RabbitTigers/CN0566Allegro2KiCAD/PABA-DP.kicad_pcb

## KiCad design PABA-DP.kicad_pcb (2025-05-30)

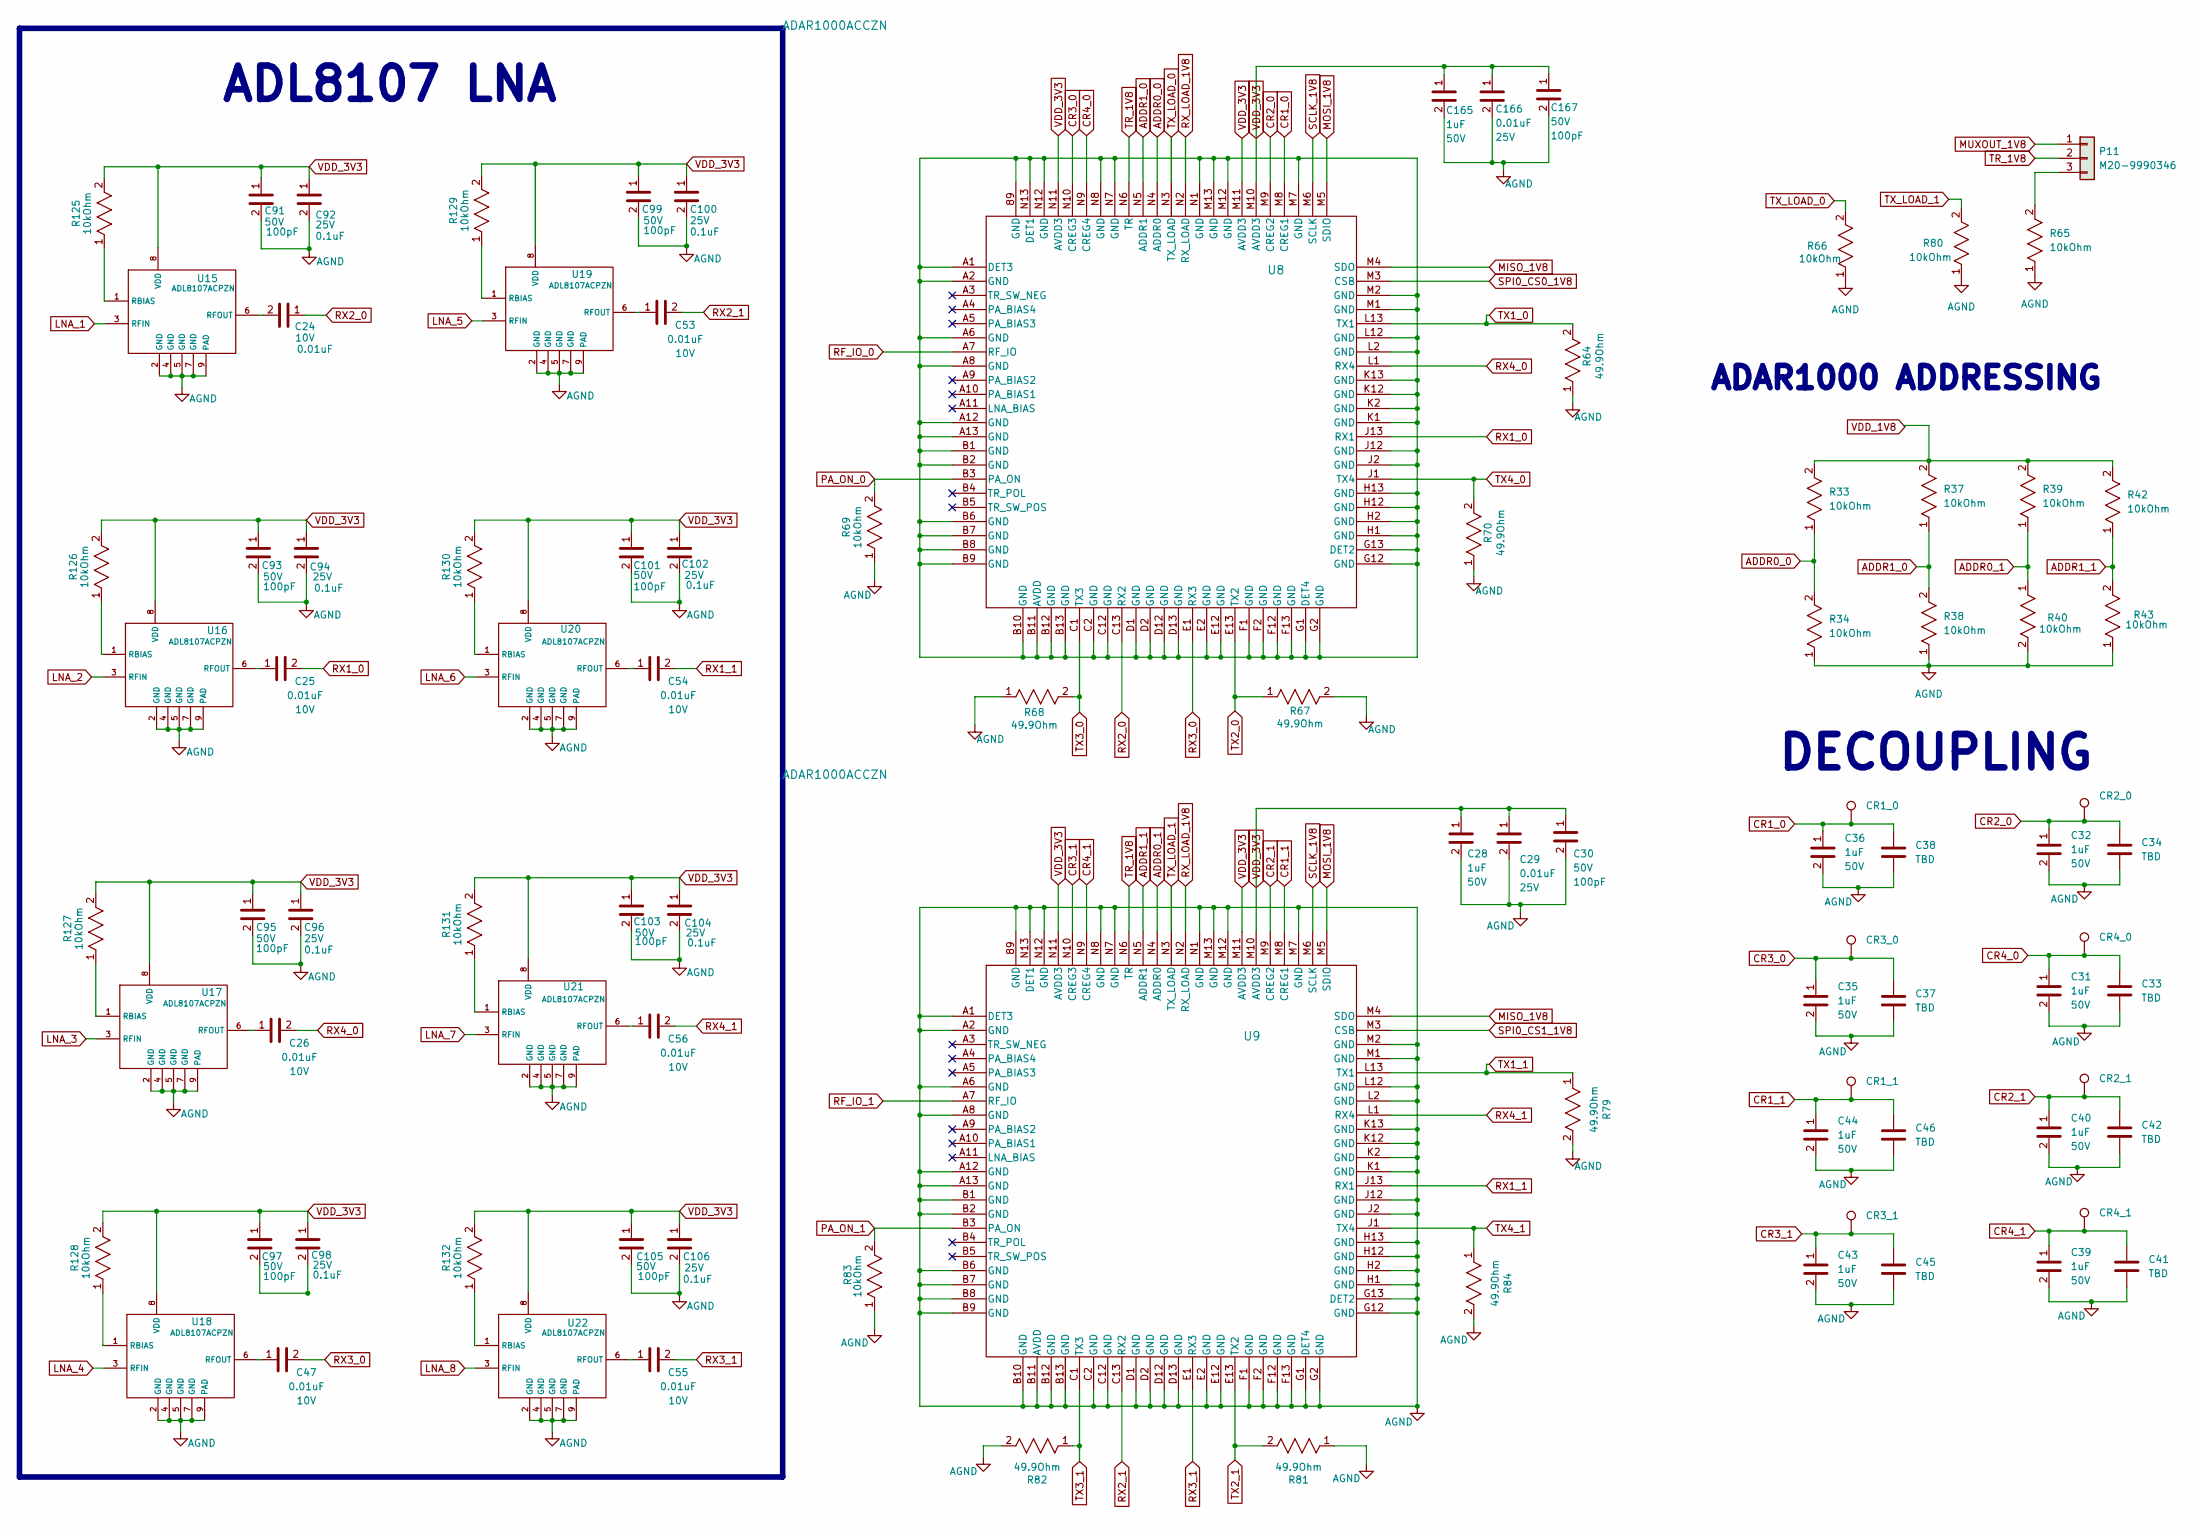
[picture p1: schematic 5.kicad_sch]

Parts:
C24, C25, C26, C47, C53, C54, C55, C56: GRM033R71A103KA01D; C_0201_0603Metric
C28, C31, C32, C35, C36, C39, C40, C43, C44, C165: CL10A105KB8NNNC; C_0603_1608Metric
C29, C166: CL10B103KA8NNNC; C_0603_1608Metric
C30, C91, C93, C95, C97, C99, C101, C103, C105, C167: CC0603KRX7R9BB101; C_0603_1608Metric
C33, C34, C37, C38, C41, C42, C45, C46: TBD; C_0402_1005Metric
C92, C94, C96, C98, C100, C102, C104, C106: CL10B104KA8NNNC; C_0603_1608Metric
CR1_0, CR1_1, CR2_0, CR2_1, CR3_0, CR3_1, CR4_0, CR4_1: TestPoint; Testpoint
P11: M20-9990346; PinHeader_1x03_P2.54mm_Vertical
R33, R34, R37, R38, R39, R40, R42, R43, R65, R66, R69, R80, R83, R125, R126, R127, R128, R129, R130, R131, R132: ERJ-3EKF1002V; R_0603_1608Metric
R64, R67, R68, R70, R79, R81, R82, R84: ERJ-1GNF49R9C; R_0201_0603Metric
U8, U9: ADAR1000ACCZN
U15, U16, U17, U18, U19, U20, U21, U22: ADL8107ACPZN; ADL8107ACPZN-R7

Connections:
ADDR0_0: U8.N4 (ADDR0)
ADDR0_1: R39.1, R40.1, U9.N4 (ADDR0)
ADDR1_0: R37.1, R38.2, U8.N5 (ADDR1)
ADDR1_1: R42.1, R43.2, U9.N5 (ADDR1)
AGND: C28.2, C29.2, C30.2, C31.2, C32.2, C33.2, C34.2, C35.2, C36.2, C37.2, C38.2, C39.2, C40.2, C41.2, C42.2, C43.2, C44.2, C45.2, C46.2, C91.2, C92.2, C93.2, C94.2, C95.2, C96.2, C99.2, C100.2, C101.2, C102.2, C103.2, C104.2, C105.2, C106.2, C165.2, C166.2, C167.2, R34.1, R38.1, R40.2, R43.1, R64.1, R65.1, R66.1, R67.2, R68.1, R69.1, R70.1, R79.2, R80.1, R81.1, R82.2, R83.1, R84.2, U9.89 (GND), U9.A1 (DET3), U9.A2 (GND), U9.A6 (GND), U9.A8 (GND), U9.A12 (GND), U9.A13 (GND), U9.B1 (GND), U9.B2 (GND), U9.B6 (GND), U9.B7 (GND), U9.B8 (GND), U9.B9 (GND), U9.B10 (GND), U9.B11 (AVDD), U9.B12 (GND), U9.B13 (GND), U9.C2 (GND), U9.C12 (GND), U9.D1 (GND), U9.D2 (GND), U9.D12 (GND), U9.D13 (GND), U9.E2 (GND), U9.E12 (GND), U9.F1 (GND), U9.F2 (GND), U9.F12 (GND), U9.F13 (GND), U9.G1 (DET4), U9.G2 (GND), U9.G12 (GND), U9.G13 (DET2), U9.H1 (GND), U9.H2 (GND), U9.H12 (GND), U9.H13 (GND), U9.J2 (GND), U9.J12 (GND), U9.K1 (GND), U9.K2 (GND), U9.K12 (GND), U9.K13 (GND), U9.L2 (GND), U9.L12 (GND), U9.M1 (GND), U9.M2 (GND), U9.M7 (GND), U9.M12 (GND), U9.M13 (GND), U9.N1 (GND), U9.N7 (GND), U9.N8 (GND), U9.N12 (GND), U9.N13 (DET1), U15.2 (GND), U15.4 (GND), U15.5 (GND), U15.7 (GND), U15.9 (PAD), U16.2 (GND), U16.4 (GND), U16.5 (GND), U16.7 (GND), U16.9 (PAD), U17.2 (GND), U17.4 (GND), U17.5 (GND), U17.7 (GND), U17.9 (PAD), U18.2 (GND), U18.4 (GND), U18.5 (GND), U18.7 (GND), U18.9 (PAD), U19.2 (GND), U19.4 (GND), U19.5 (GND), U19.7 (GND), U19.9 (PAD), U20.2 (GND), U20.4 (GND), U20.5 (GND), U20.7 (GND), U20.9 (PAD), U21.2 (GND), U21.4 (GND), U21.5 (GND), U21.7 (GND), U21.9 (PAD), U22.2 (GND), U22.4 (GND), U22.5 (GND), U22.7 (GND), U22.9 (PAD); also elsewhere on the board
CR1_0: C36.1, C38.1, CR1_0.1, U8.M8 (CREG1)
CR1_1: C44.1, C46.1, CR1_1.1, U9.M8 (CREG1)
CR2_0: C32.1, C34.1, CR2_0.1, U8.M9 (CREG2)
CR2_1: C40.1, C42.1, CR2_1.1, U9.M9 (CREG2)
CR3_0: C35.1, C37.1, CR3_0.1, U8.N10 (CREG3)
CR3_1: C43.1, C45.1, CR3_1.1, U9.N10 (CREG3)
CR4_0: C31.1, C33.1, CR4_0.1, U8.N9 (CREG4)
CR4_1: C39.1, C41.1, CR4_1.1, U9.N9 (CREG4)
LNA_1: U15.3 (RFIN); also elsewhere on the board
LNA_2: U16.3 (RFIN); also elsewhere on the board
LNA_3: U17.3 (RFIN); also elsewhere on the board
LNA_4: U18.3 (RFIN); also elsewhere on the board
LNA_5: U19.3 (RFIN); also elsewhere on the board
LNA_6: U20.3 (RFIN); also elsewhere on the board
LNA_7: U21.3 (RFIN); also elsewhere on the board
LNA_8: U22.3 (RFIN); also elsewhere on the board
MISO_1V8: U8.M4 (SDO), U9.M4 (SDO); also elsewhere on the board
MOSI_1V8: U8.M5 (SDIO), U9.M5 (SDIO); also elsewhere on the board
MUXOUT_1V8: P11.1; also elsewhere on the board
unnamed: C97.2, C98.2
unnamed: P11.3, R65.2
unnamed: R33.1, R34.2
unnamed: U8.89 (GND), U8.A1 (DET3), U8.A2 (GND), U8.A6 (GND), U8.A8 (GND), U8.A12 (GND), U8.A13 (GND), U8.B1 (GND), U8.B2 (GND), U8.B6 (GND), U8.B7 (GND), U8.B8 (GND), U8.B9 (GND), U8.B10 (GND), U8.B11 (AVDD), U8.B12 (GND), U8.B13 (GND), U8.C2 (GND), U8.C12 (GND), U8.D1 (GND), U8.D2 (GND), U8.D12 (GND), U8.D13 (GND), U8.E2 (GND), U8.E12 (GND), U8.F1 (GND), U8.F2 (GND), U8.F12 (GND), U8.F13 (GND), U8.G1 (DET4), U8.G2 (GND), U8.G12 (GND), U8.G13 (DET2), U8.H1 (GND), U8.H2 (GND), U8.H12 (GND), U8.H13 (GND), U8.J2 (GND), U8.J12 (GND), U8.K1 (GND), U8.K2 (GND), U8.K12 (GND), U8.K13 (GND), U8.L2 (GND), U8.L12 (GND), U8.M1 (GND), U8.M2 (GND), U8.M7 (GND), U8.M12 (GND), U8.M13 (GND), U8.N1 (GND), U8.N7 (GND), U8.N8 (GND), U8.N12 (GND), U8.N13 (DET1)
unnamed: R125.1, U15.1 (RBIAS)
unnamed: C24.2, U15.6 (RFOUT)
unnamed: R126.1, U16.1 (RBIAS)
unnamed: C25.1, U16.6 (RFOUT)
unnamed: R127.1, U17.1 (RBIAS)
unnamed: C26.1, U17.6 (RFOUT)
unnamed: R128.1, U18.1 (RBIAS)
unnamed: C47.1, U18.6 (RFOUT)
unnamed: R129.1, U19.1 (RBIAS)
unnamed: C53.1, U19.6 (RFOUT)
unnamed: R130.1, U20.1 (RBIAS)
unnamed: C54.1, U20.6 (RFOUT)
unnamed: R131.1, U21.1 (RBIAS)
unnamed: C56.1, U21.6 (RFOUT)
unnamed: R132.1, U22.1 (RBIAS)
unnamed: C55.1, U22.6 (RFOUT)
PA_ON_0: R69.2, U8.B3 (PA_ON)
PA_ON_1: R83.2, U9.B3 (PA_ON)
RF_IO_0: U8.A7 (RF_IO); also elsewhere on the board
RF_IO_1: U9.A7 (RF_IO); also elsewhere on the board
RX1_0: C25.2, U8.J13 (RX1)
RX1_1: C54.2, U9.J13 (RX1)
RX2_0: C24.1, U8.C13 (RX2)
RX2_1: C53.2, U9.C13 (RX2)
RX3_0: C47.2, U8.E1 (RX3)
RX3_1: C55.2, U9.E1 (RX3)
RX4_0: C26.2, U8.L1 (RX4)
RX4_1: C56.2, U9.L1 (RX4)
RX_LOAD_1V8: U8.N2 (RX_LOAD), U9.N2 (RX_LOAD); also elsewhere on the board
SCLK_1V8: U8.M6 (SCLK), U9.M6 (SCLK); also elsewhere on the board
SPI0_CS0_1V8: U8.M3 (CSB); also elsewhere on the board
SPI0_CS1_1V8: U9.M3 (CSB); also elsewhere on the board
TR_1V8: P11.2, U8.N6 (TR), U9.N6 (TR); also elsewhere on the board
TX1_0: R64.2, U8.L13 (TX1)
TX1_1: R79.1, U9.L13 (TX1)
TX2_0: R67.1, U8.E13 (TX2)
TX2_1: R81.2, U9.E13 (TX2)
TX3_0: R68.2, U8.C1 (TX3)
TX3_1: R82.1, U9.C1 (TX3)
TX4_0: R70.2, U8.J1 (TX4)
TX4_1: R84.1, U9.J1 (TX4)
TX_LOAD_0: R66.2, U8.N3 (TX_LOAD)
TX_LOAD_1: R80.2, U9.N3 (TX_LOAD)
VDD_1V8: R33.2, R37.2, R39.2, R42.2; also elsewhere on the board
VDD_3V3: C28.1, C29.1, C30.1, C91.1, C92.1, C93.1, C94.1, C95.1, C96.1, C97.1, C98.1, C99.1, C100.1, C101.1, C102.1, C103.1, C104.1, C105.1, C106.1, C165.1, C166.1, C167.1, R125.2, R126.2, R127.2, R128.2, R129.2, R130.2, R131.2, R132.2, U8.M10 (AVDD3), U8.M11 (AVDD3), U8.N11 (AVDD3), U9.M10 (AVDD3), U9.M11 (AVDD3), U9.N11 (AVDD3), U15.8 (VDD), U16.8 (VDD), U17.8 (VDD), U18.8 (VDD), U19.8 (VDD), U20.8 (VDD), U21.8 (VDD), U22.8 (VDD); also elsewhere on the board

Notes on the sheet:
ADL8107 LNA
ADAR1000 ADDRESSING
DECOUPLING

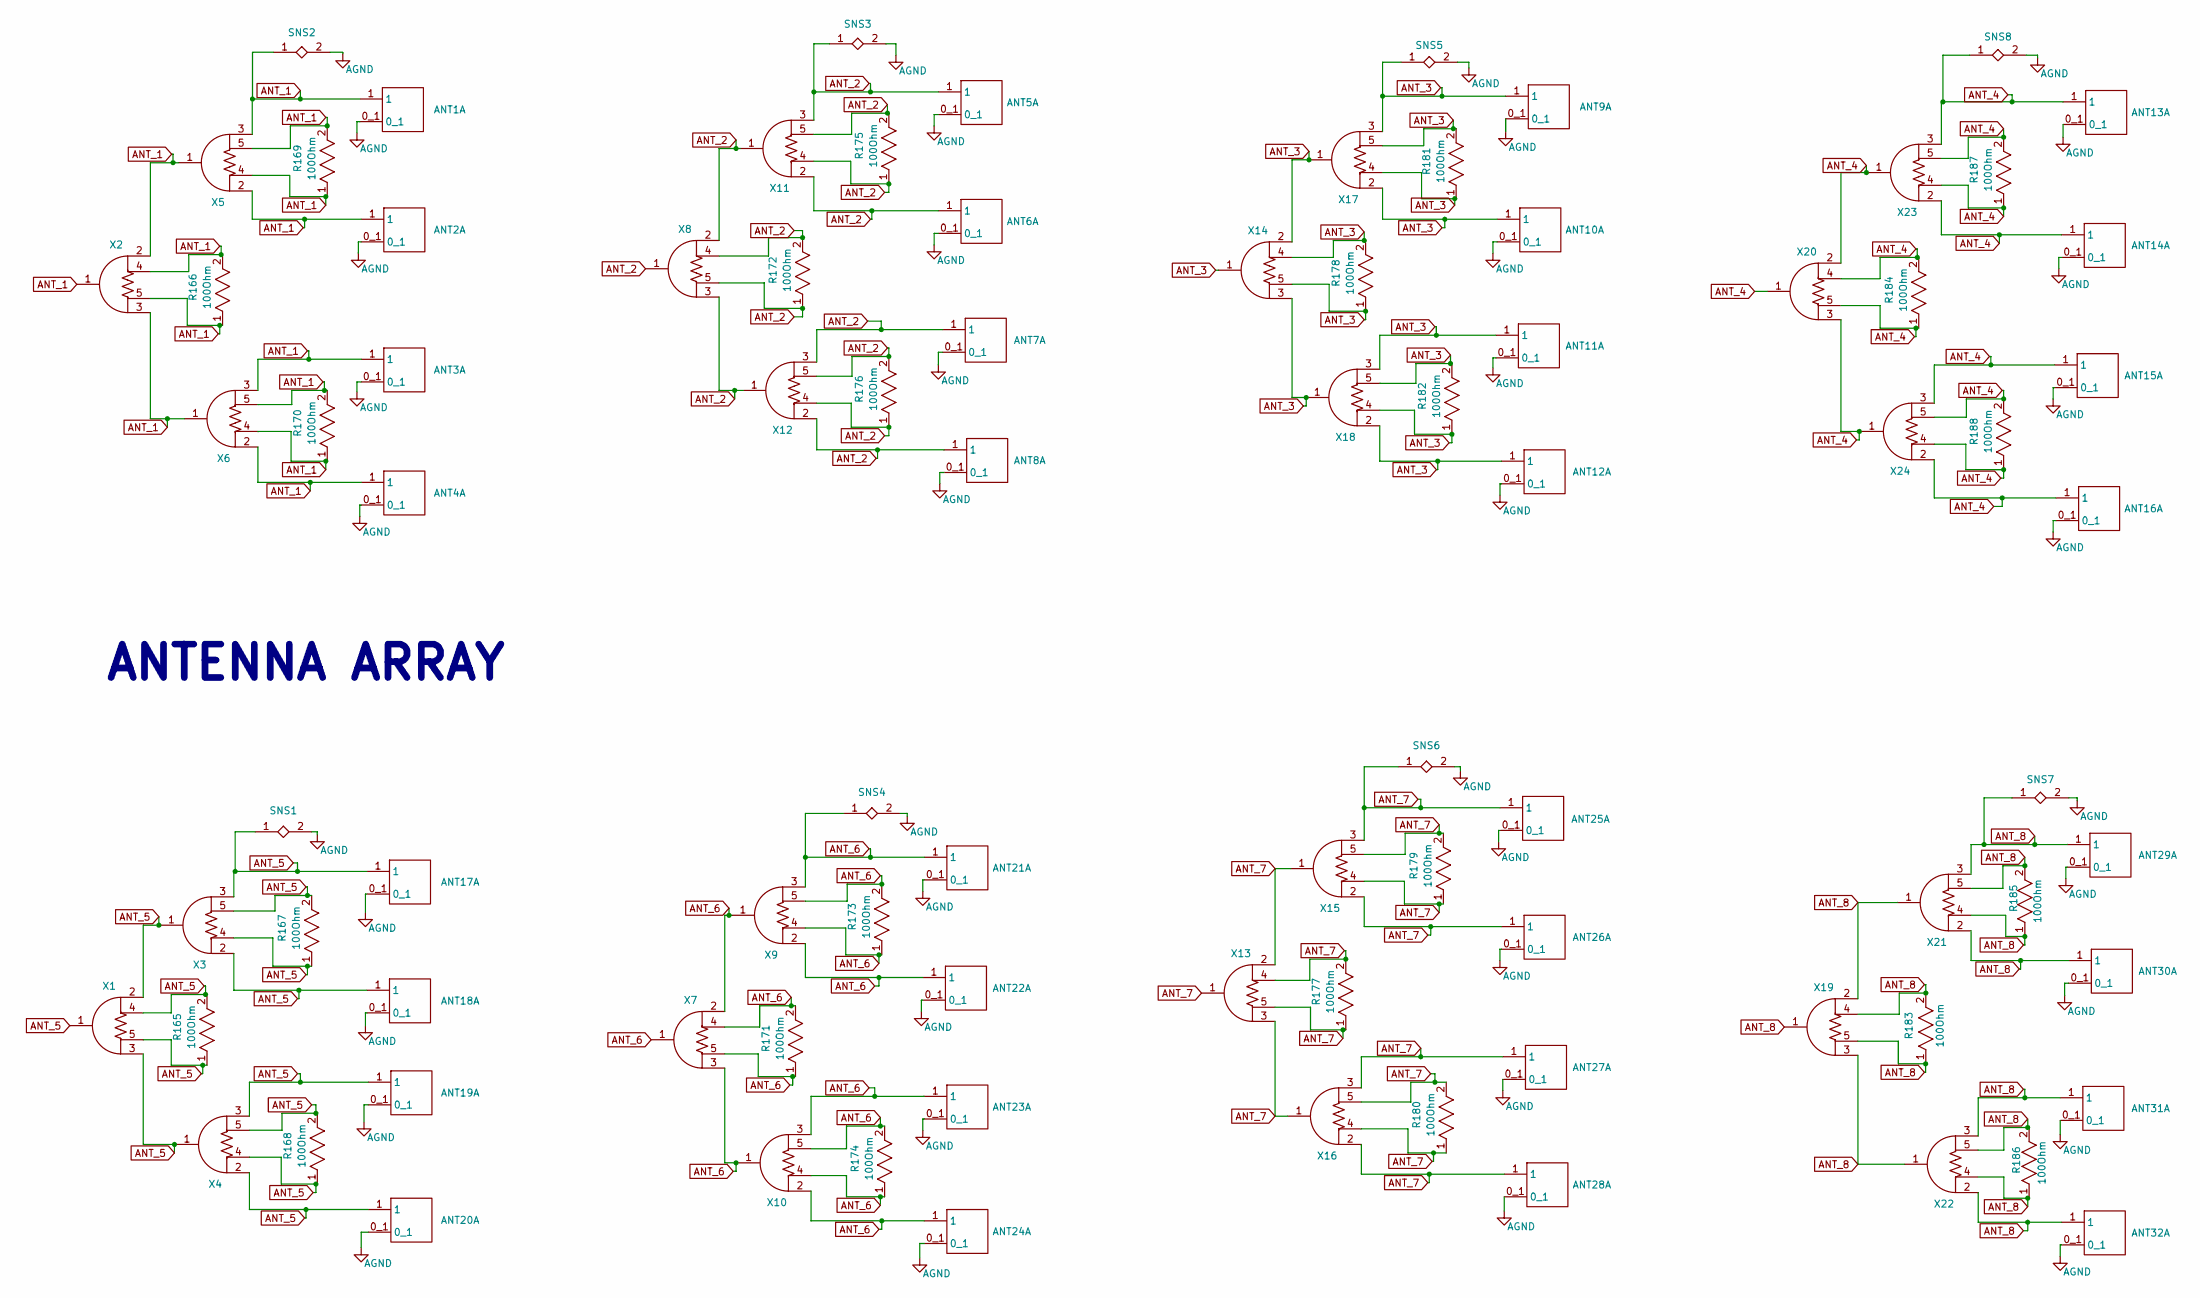
[picture p2: schematic 4.kicad_sch]

Parts:
ANT1, ANT2, ANT3, ANT4, ANT5, ANT6, ANT7, ANT8, ANT9, ANT10, ANT11, ANT12, ANT13, ANT14, ANT15, ANT16, ANT17, ANT18, ANT19, ANT20, ANT21, ANT22, ANT23, ANT24, ANT25, ANT26, ANT27, ANT28, ANT29, ANT30, ANT31, ANT32: Patch_Ant; Patch Antenna
R165, R166, R167, R168, R169, R170, R171, R172, R173, R174, R175, R176, R177, R178, R179, R180, R181, R182, R183, R184, R185, R186, R187, R188: ERJ-2RKF1000X; R_0402_1005Metric
SNS1, SNS2, SNS3, SNS4, SNS5, SNS6, SNS7, SNS8: NCSNS20MILL; SNS50Mill
X1, X2, X3, X4, X5, X6, X7, X8, X9, X10, X11, X12, X13, X14, X15, X16, X17, X18, X19, X20, X21, X22, X23, X24: 5P_Wilkinson_Divider; 5Pos Wilkinson divider

Connections:
AGND: ANT1.0_1, ANT2.0_1, ANT3.0_1, ANT4.0_1, ANT5.0_1, ANT6.0_1, ANT7.0_1, ANT8.0_1, ANT9.0_1, ANT10.0_1, ANT11.0_1, ANT12.0_1, ANT13.0_1, ANT14.0_1, ANT15.0_1, ANT16.0_1, ANT17.0_1, ANT18.0_1, ANT19.0_1, ANT20.0_1, ANT21.0_1, ANT22.0_1, ANT23.0_1, ANT24.0_1, ANT25.0_1, ANT26.0_1, ANT27.0_1, ANT28.0_1, ANT29.0_1, ANT30.0_1, ANT31.0_1, ANT32.0_1, SNS1.2, SNS2.2, SNS3.2, SNS4.2, SNS5.2, SNS6.2, SNS7.2, SNS8.2; also elsewhere on the board
ANT_1: ANT1.1, ANT2.1, ANT3.1, ANT4.1, R166.1, R166.2, R169.1, R169.2, R170.1, R170.2, SNS2.1, X2.1, X2.2, X2.3, X2.4, X2.5, X5.1, X5.2, X5.3, X5.4, X5.5, X6.1, X6.2, X6.3, X6.4, X6.5; also elsewhere on the board
ANT_2: ANT5.1, ANT6.1, ANT7.1, ANT8.1, R172.1, R172.2, R175.1, R175.2, R176.1, R176.2, SNS3.1, X8.1, X8.2, X8.3, X8.4, X8.5, X11.1, X11.2, X11.3, X11.4, X11.5, X12.1, X12.2, X12.3, X12.4, X12.5; also elsewhere on the board
ANT_3: ANT9.1, ANT10.1, ANT11.1, ANT12.1, R178.1, R178.2, R181.1, R181.2, R182.1, R182.2, SNS5.1, X14.1, X14.2, X14.3, X14.4, X14.5, X17.1, X17.2, X17.3, X17.4, X17.5, X18.1, X18.2, X18.3, X18.4, X18.5; also elsewhere on the board
ANT_4: ANT13.1, ANT14.1, ANT15.1, ANT16.1, R184.1, R184.2, R187.1, R187.2, R188.1, R188.2, SNS8.1, X20.1, X20.2, X20.3, X20.4, X20.5, X23.1, X23.2, X23.3, X23.4, X23.5, X24.1, X24.2, X24.3, X24.4, X24.5; also elsewhere on the board
ANT_5: ANT17.1, ANT18.1, ANT19.1, ANT20.1, R165.1, R165.2, R167.1, R167.2, R168.1, R168.2, SNS1.1, X1.1, X1.2, X1.3, X1.4, X1.5, X3.1, X3.2, X3.3, X3.4, X3.5, X4.1, X4.2, X4.3, X4.4, X4.5; also elsewhere on the board
ANT_6: ANT21.1, ANT22.1, ANT23.1, ANT24.1, R171.1, R171.2, R173.1, R173.2, R174.1, R174.2, SNS4.1, X7.1, X7.2, X7.3, X7.4, X7.5, X9.1, X9.2, X9.3, X9.4, X9.5, X10.1, X10.2, X10.3, X10.4, X10.5; also elsewhere on the board
ANT_7: ANT25.1, ANT26.1, ANT27.1, ANT28.1, R177.1, R177.2, R179.1, R179.2, R180.1, R180.2, SNS6.1, X13.1, X13.2, X13.3, X13.4, X13.5, X15.1, X15.2, X15.3, X15.4, X15.5, X16.1, X16.2, X16.3, X16.4, X16.5; also elsewhere on the board
ANT_8: ANT29.1, ANT30.1, ANT31.1, ANT32.1, R183.1, R183.2, R185.1, R185.2, R186.1, R186.2, SNS7.1, X19.1, X19.2, X19.3, X19.4, X19.5, X21.1, X21.2, X21.3, X21.4, X21.5, X22.1, X22.2, X22.3, X22.4, X22.5; also elsewhere on the board

Notes on the sheet:
ANTENNA ARRAY

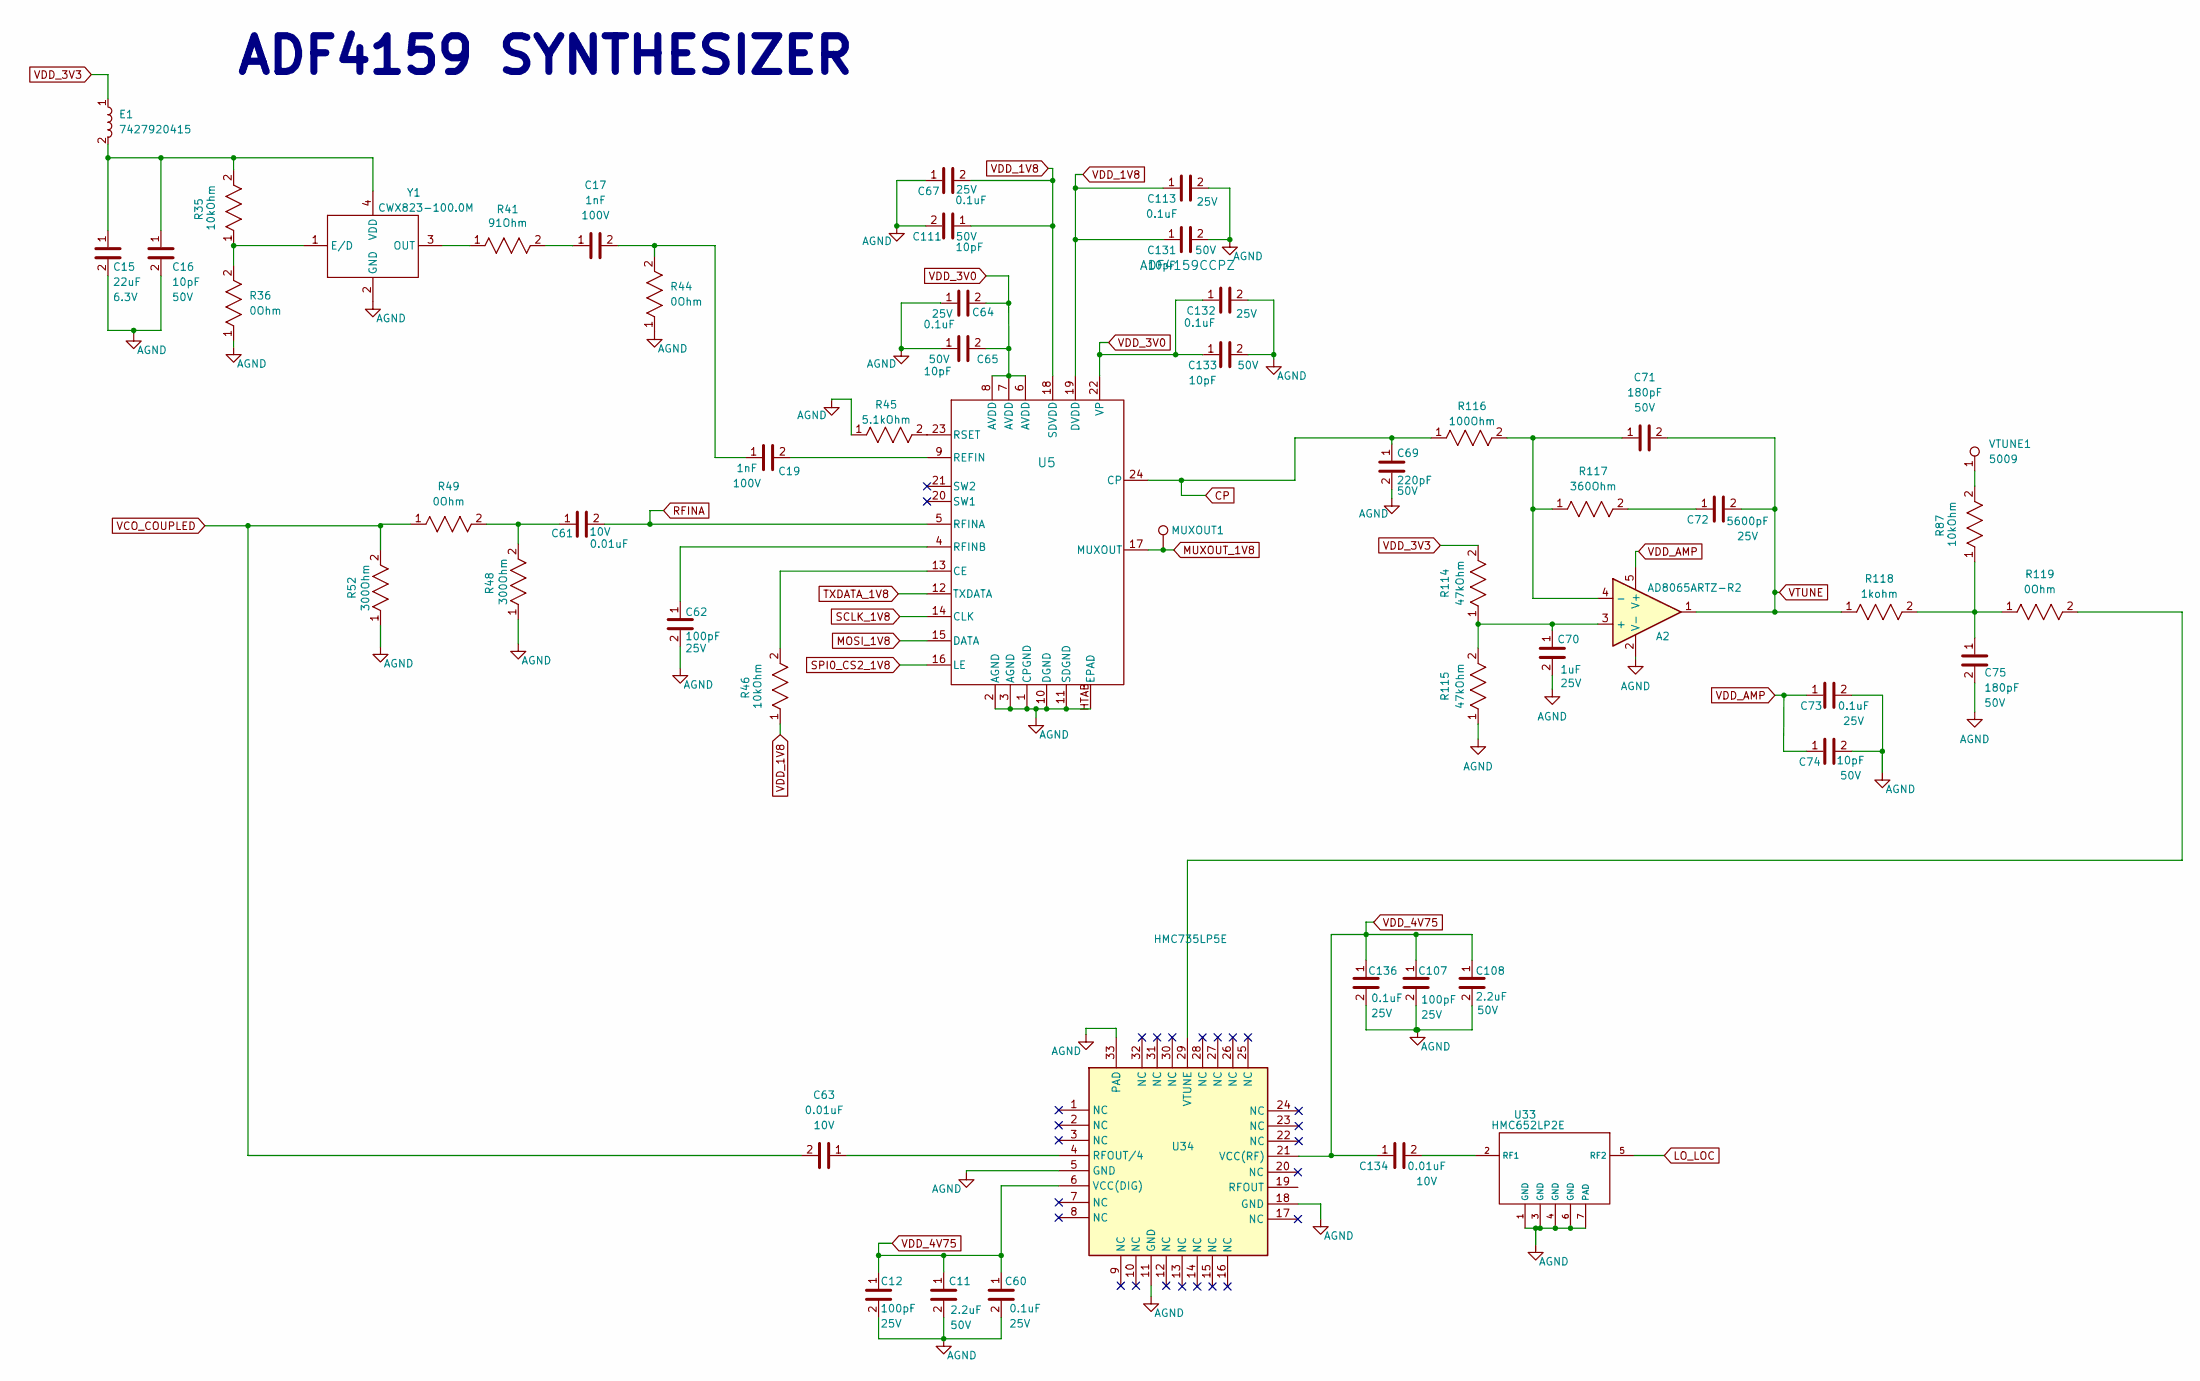
[picture p3: schematic 8.kicad_sch]

Parts:
A2: AD8065ARTZ-R2; SOT-23-5
C11, C108: GRM188R61H225KE11J; C_0603_1608Metric
C12, C62, C107: GRM033R71E101KA01D; C_0201_0603Metric
C15: GRM21BR60J226ME39L; C_0805_2012Metric
C16, C65, C74, C111, C131, C133: CC0402JRNPO9BN100; C_0402_1005Metric
C17, C19: 06031C102KAT2A; C_0603_1608Metric
C60, C64, C67, C73, C113, C132, C136: GRM155R71E104KE14D; C_0402_1005Metric
C61, C63, C134: GRM033R71A103KA01D; C_0201_0603Metric
C69: GRM0335C1H221JA01D; C_0201_0603Metric
C70: C1005X5R1E105K050BC; C_0402_1005Metric
C71, C75: CL05C181JB5NNNC; C_0402_1005Metric
C72: C0603C562J3GACTU; C_0603_1608Metric
E1: 7427920415; L_0805_2012Metric_Pad1.05x1.20mm_HandSolder
MUXOUT1: TestPoint; Testpoint
R35, R46, R87: ERJ-1GNF1002C; R_0201_0603Metric
R36, R44, R49, R119: ERJ-2GE0R00X; R_0402_1005Metric
R41: RC0603FR-0791RL; R_0603_1608Metric
R45: ERJ-1GNF5101C; R_0201_0603Metric
R48, R52: ERJ-1GNF3000C; R_0201_0603Metric
R114, R115: ERJ-1GNF4702C; R_0201_0603Metric
R116: ERJ-2RKF1000X; R_0402_1005Metric
R117: ERJ-2GEJ361X; R_0402_1005Metric
R118: ERJ-1GNF1001C; R_0201_0603Metric
U5: ADF4159CCPZ
U33: HMC652LP2E; HMC652LP2E TDFN 2x2
U34: HMC735LP5E; QFN-32-1EP_5x5mm_P0.5mm_EP3.7x3.7mm
VTUNE1: 5009; KEYSTONE_5009
Y1: CWX823-100.0M

Connections:
AGND: A2.2 (V-), C11.2, C12.2, C15.2, C16.2, C60.2, C62.2, C64.1, C65.1, C67.1, C69.2, C70.2, C73.2, C74.2, C75.2, C107.2, C108.2, C111.2, C113.2, C131.2, C132.2, C133.2, C136.2, R36.1, R44.1, R45.1, R48.1, R52.1, R115.1, U5.1 (CPGND), U5.2 (AGND), U5.3 (AGND), U5.10 (DGND), U5.11 (SDGND), U5.HTAB (EPAD), U33.1 (GND), U33.3 (GND), U33.4 (GND), U33.6 (GND), U33.7 (PAD), U34.5 (GND), U34.11 (GND), U34.18 (GND), U34.33 (PAD), Y1.2 (GND); also elsewhere on the board
CP: C69.1, R116.1, U5.24 (CP)
LO_LOC: U33.5 (RF2); also elsewhere on the board
MOSI_1V8: U5.15 (DATA); also elsewhere on the board
MUXOUT_1V8: MUXOUT1.1, U5.17 (MUXOUT); also elsewhere on the board
unnamed: A2.3 (+), C70.1, R114.1, R115.2
unnamed: A2.4 (-), C71.1, R116.2, R117.1
unnamed: C17.1, R41.2
unnamed: C17.2, C19.1, R44.2
unnamed: C61.1, R48.2, R49.2
unnamed: C72.1, R117.2
unnamed: C75.1, R87.1, R118.2, R119.1
unnamed: R87.2, VTUNE1.1
unnamed: R46.2, U5.13 (CE)
unnamed: C19.2, U5.9 (REFIN)
unnamed: C62.1, U5.4 (RFINB)
unnamed: R45.2, U5.23 (RSET)
unnamed: C134.2, U33.2 (RF1)
unnamed: C63.1, U34.4 (RFOUT/4)
unnamed: R119.2, U34.29 (VTUNE)
unnamed: R35.1, R36.2, Y1.1 (E/D)
unnamed: R41.1, Y1.3 (OUT)
unnamed: C15.1, C16.1, E1.2, R35.2, Y1.4 (VDD)
RFINA: C61.2, U5.5 (RFINA)
SCLK_1V8: U5.14 (CLK); also elsewhere on the board
SPI0_CS2_1V8: U5.16 (LE); also elsewhere on the board
TXDATA_1V8: U5.12 (TXDATA); also elsewhere on the board
VCO_COUPLED: C63.2, R49.1, R52.2
VDD_1V8: C67.2, C111.1, C113.1, C131.1, R46.1, U5.18 (SDVDD), U5.19 (DVDD); also elsewhere on the board
VDD_3V0: C64.2, C65.2, C132.1, C133.1, U5.6 (AVDD), U5.7 (AVDD), U5.8 (AVDD), U5.22 (VP); also elsewhere on the board
VDD_3V3: E1.1, R114.2; also elsewhere on the board
VDD_4V75: C11.1, C12.1, C60.1, C107.1, C108.1, C134.1, C136.1, U34.6 (VCC(DIG)), U34.21 (VCC(RF)); also elsewhere on the board
VDD_AMP: A2.5 (V+), C73.1, C74.1; also elsewhere on the board
VTUNE: A2.1, C71.2, C72.2, R118.1; also elsewhere on the board

Notes on the sheet:
ADF4159 SYNTHESIZER

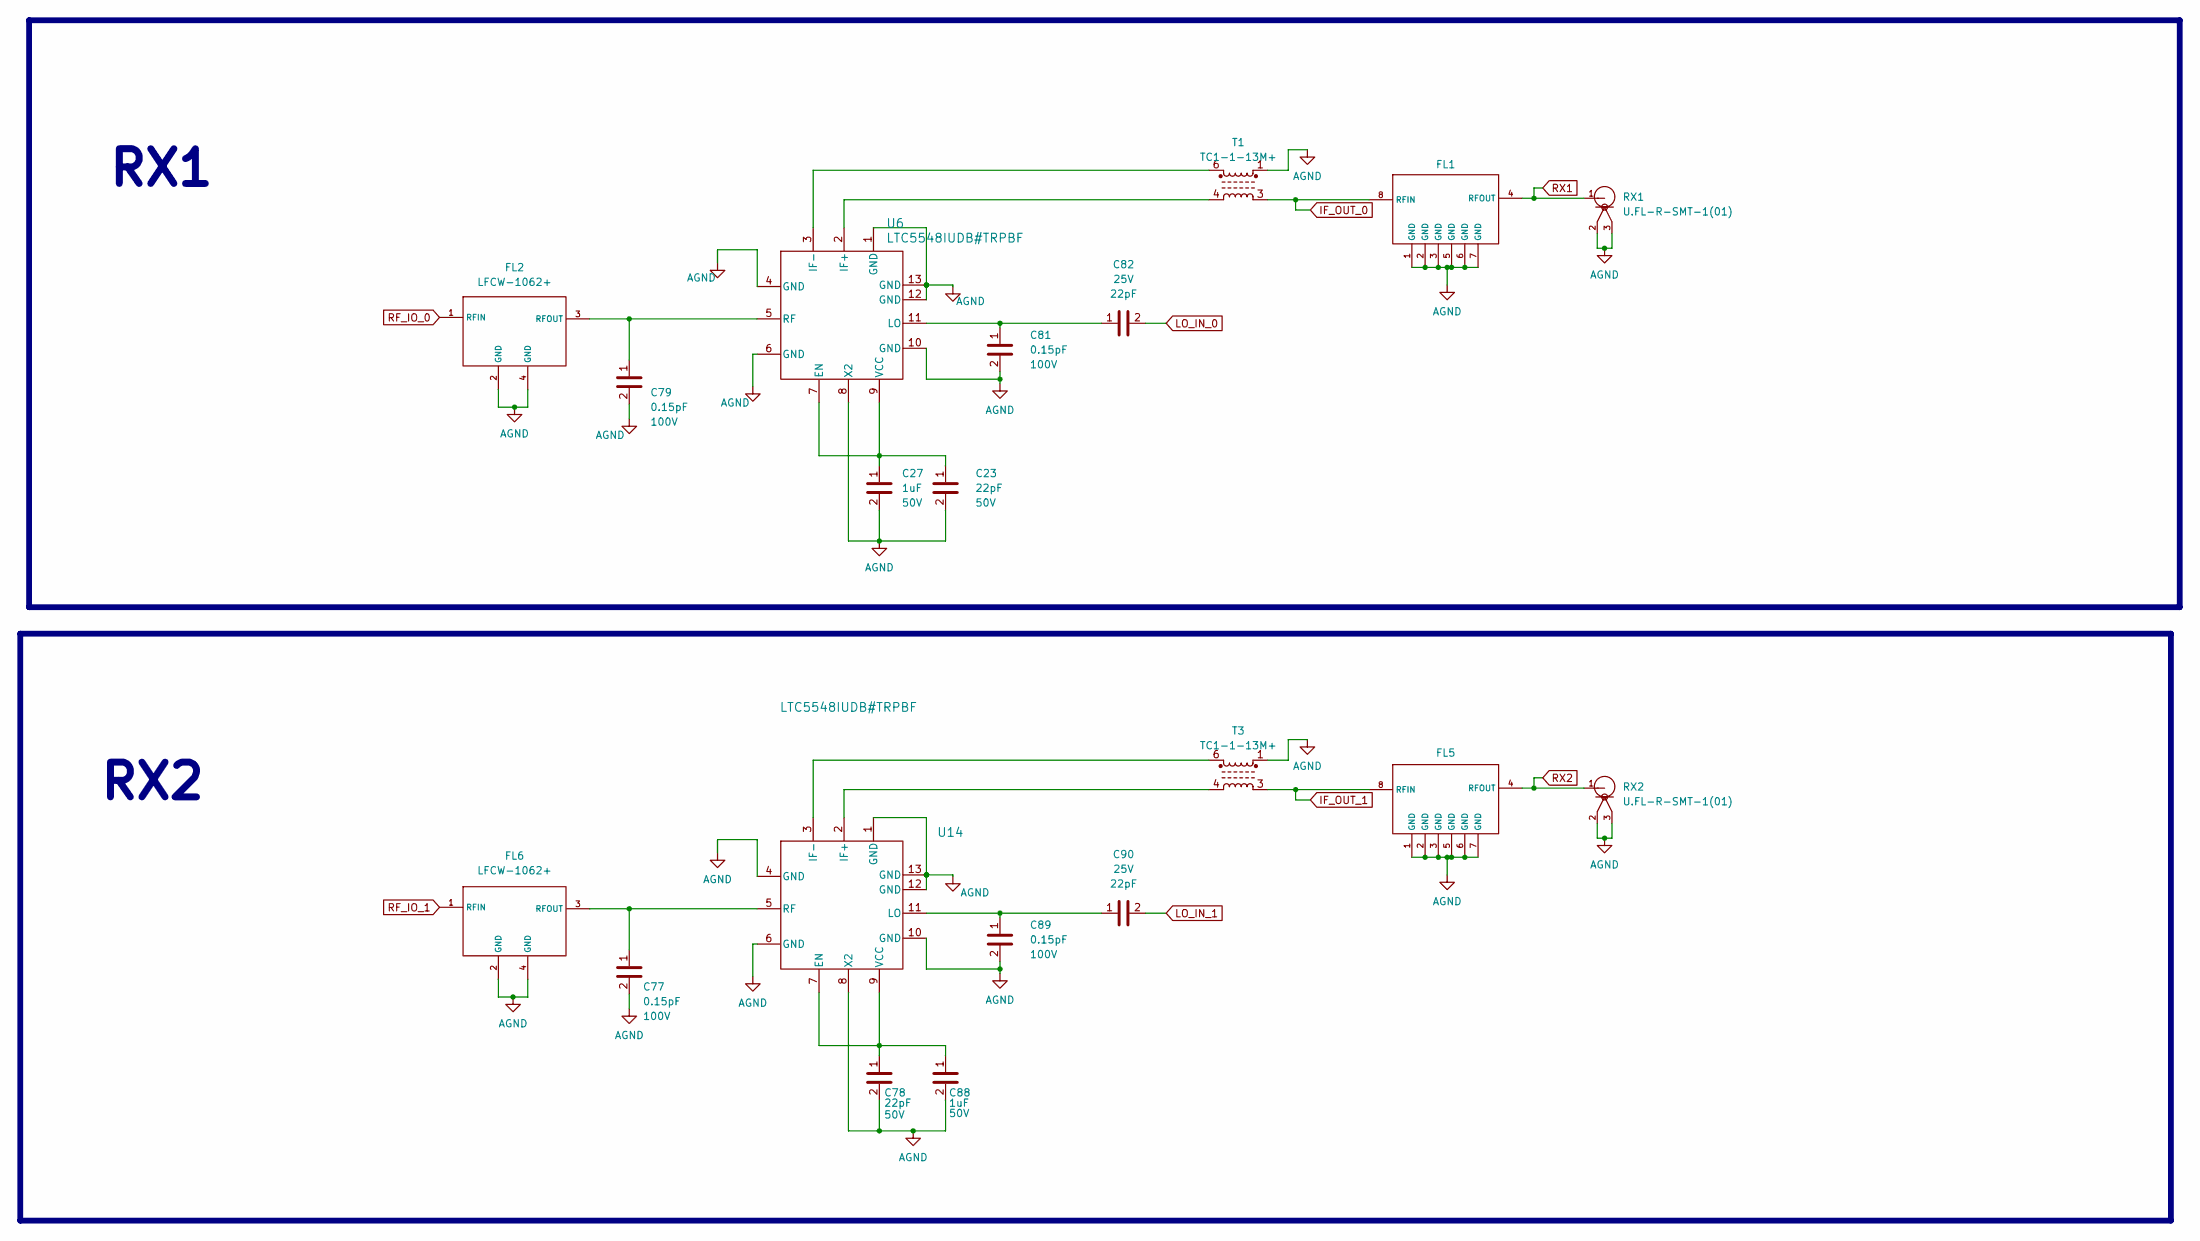
[picture p4: schematic 6.kicad_sch]

Parts:
C23, C78: 06035C220JAT2A; C_0603_1608Metric
C27, C88: CL10A105KB8NNNC; C_0603_1608Metric
C77, C79, C81, C89: 02011JR15ZBSTR; C_0201_0603Metric
C82, C90: GRM0335C1E220JA01D; C_0201_0603Metric
FL1, FL5: LFCG-2500+; LFCG2500
FL2, FL6: LFCW-1062+
RX1, RX2: U.FL-R-SMT-1(01); COAX2_U.FL-R-SMT-101_HIR
T1, T3: TC1-1-13M+
U6, U14: LTC5548IUDB#TRPBF

Connections:
AGND: C23.2, C27.2, C77.2, C78.2, C79.2, C81.2, C88.2, C89.2, FL1.1 (GND), FL1.2 (GND), FL1.3 (GND), FL1.5 (GND), FL1.6 (GND), FL1.7 (GND), FL2.2 (GND), FL2.4 (GND), FL5.1 (GND), FL5.2 (GND), FL5.3 (GND), FL5.5 (GND), FL5.6 (GND), FL5.7 (GND), FL6.2 (GND), FL6.4 (GND), RX1.2, RX1.3, RX2.2, RX2.3, T1.1, T3.1, U6.1 (GND), U6.4 (GND), U6.6 (GND), U6.8 (X2), U6.10 (GND), U6.12 (GND), U6.13 (GND), U14.1 (GND), U14.4 (GND), U14.6 (GND), U14.8 (X2), U14.10 (GND), U14.12 (GND), U14.13 (GND); also elsewhere on the board
IF_OUT_0: FL1.8 (RFIN), T1.3
IF_OUT_1: FL5.8 (RFIN), T3.3
LO_IN_0: C82.2; also elsewhere on the board
LO_IN_1: C90.2; also elsewhere on the board
unnamed: C79.1, FL2.3 (RFOUT), U6.5 (RF)
unnamed: C77.1, FL6.3 (RFOUT), U14.5 (RF)
unnamed: C23.1, C27.1, U6.7 (EN), U6.9 (VCC)
unnamed: T1.4, U6.2 (IF+)
unnamed: T1.6, U6.3 (IF-)
unnamed: C81.1, C82.1, U6.11 (LO)
unnamed: C78.1, C88.1, U14.7 (EN), U14.9 (VCC)
unnamed: T3.4, U14.2 (IF+)
unnamed: T3.6, U14.3 (IF-)
unnamed: C89.1, C90.1, U14.11 (LO)
RF_IO_0: FL2.1 (RFIN); also elsewhere on the board
RF_IO_1: FL6.1 (RFIN); also elsewhere on the board
RX1: FL1.4 (RFOUT), RX1.1
RX2: FL5.4 (RFOUT), RX2.1

Notes on the sheet:
RX2
RX1
