RabbitTigers/CN0566Allegro2KiCAD/PABA-DP.kicad_pcb

## KiCad design PABA-DP.kicad_pcb (continued)

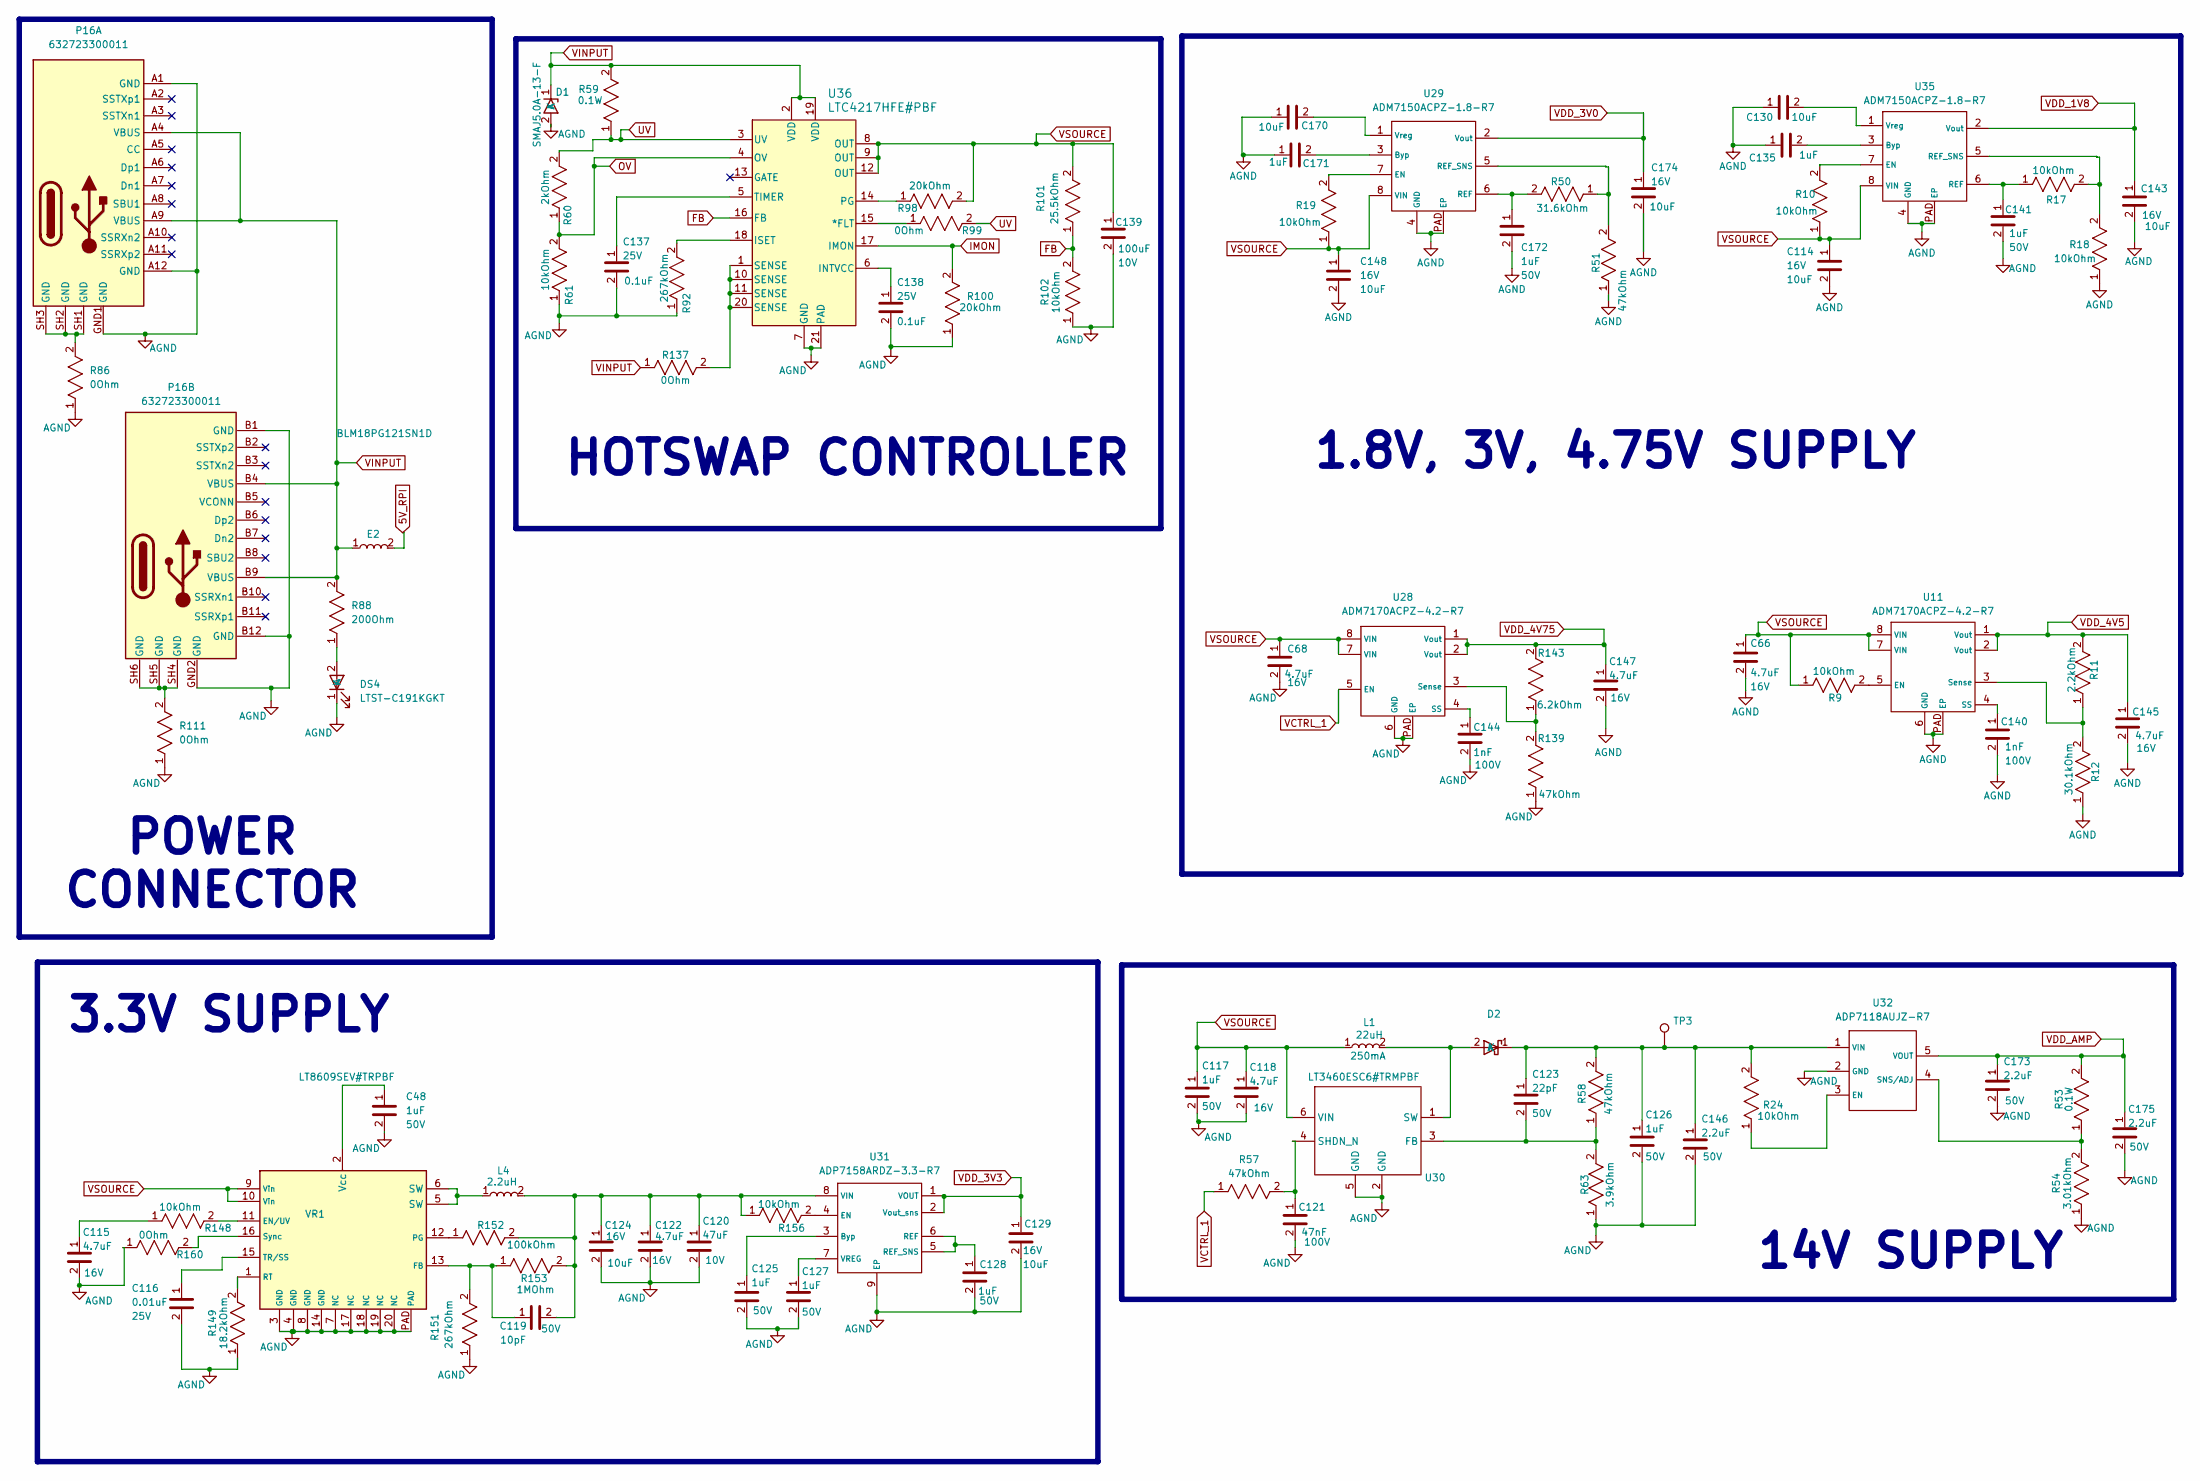
[picture p5: schematic 10.kicad_sch]

Parts:
C48, C117, C125, C126, C127, C128, C135, C141, C171, C172: CL10A105KB8NNNC; C_0603_1608Metric
C66, C68, C115, C118, C122, C145, C147: GRM188C81C475KE11D; C_0603_1608Metric
C114, C124, C129, C130, C143, C148, C170, C174: GRM188R61C106KAALD; C_0603_1608Metric
C116: CL10B103KA8NNNC; C_0603_1608Metric
C119: CL10C100JB8NNNC; C_0603_1608Metric
C120: LMK325B7476KM-PR; C_1210_3225Metric
C121: C0603C473K1RACAUTO; C_0603_1608Metric
C123: 06035C220JAT2A; C_0603_1608Metric
C137, C138: CL10B104KA8NNNC; C_0603_1608Metric
C139: CL32A107MPVNNNE; C_1210_3225Metric
C140, C144: 06031C102KAT2A; C_0603_1608Metric
C146, C173, C175: GRM188R61H225KE11J; C_0603_1608Metric
D1: SMAJ5.0A-13-F; D_SMA
D2: CMDSH2-3_TR_PBFREE; D_SOD-323
DS4: LTST-C191KGKT; LED_0603_1608Metric
E2: BLM18PG121SN1D; L_0603_1608Metric
L1: LQH32CN220K53L; LQH32CH100K53L
L4: XFL4020-222MEB; XFL4020-222ME
P16: 632723300011
R9, R10, R17, R18, R19, R24, R61, R102, R148, R156: ERJ-3EKF1002V; R_0603_1608Metric
R11: ERJ-3EKF2201V; R_0603_1608Metric
R12: ERJ-3EKF3012V; R_0603_1608Metric
R50, R53, R59: ERJ-3EKF3162V; R_0603_1608Metric
R51, R57, R58, R139: ERJ-3EKF4702V; R_0603_1608Metric
R54: ERJ-3EKF3011V; R_0603_1608Metric
R60: ERJ-3EKF2001V; R_0603_1608Metric
R63: ERJ-2RKF3901X; R_0402_1005Metric
R86, R99, R111, R137, R160: ERJ-3GEY0R00V; R_0603_1608Metric
R88: ERJ-3EKF2000V; R_0603_1608Metric
R92, R151: CRCW0603267KFKEA; R_0603_1608Metric
R98, R100: ERJ-3EKF2002V; R_0603_1608Metric
R101: ERJ-3EKF2552V; R_0603_1608Metric
R143: ERJ-2RKF6201X; R_0603_1608Metric
R149: ERJ-3EKF1822V; R_0603_1608Metric
R152: ERJ-3EKF1003V; R_0603_1608Metric
R153: ERJ-3EKF1004V; R_0603_1608Metric
TP3: TestPoint; Testpoint
U11, U28: ADM7170ACPZ-4.2-R7; ADM7170ACPZ-4.2-R7 lfcsp 3x3
U29, U35: ADM7150ACPZ-1.8-R7; ADM7170ACPZ-4.2-R7 lfcsp 3x3
U30: LT3460ESC6#TRMPBF; LT3460ESC6#TRMPBF sc-70-6 sc-88
U31: ADP7158ARDZ-3.3-R7; SOIC-8-1EP_3.9x4.9mm_P1.27mm_EP2.29x3mm
U32: ADP7118AUJZ-R7; TSOT-23-5
U36: LTC4217HFE#PBF; HTSSOP-20-1EP_4.4x6.5mm_P0.65mm_EP3.4x6.5mm_Mask2.4x3.7mm
VR1: LT8609SEV#TRPBF

Connections:
5V_RPI: E2.2; also elsewhere on the board
AGND: C48.2, C66.2, C68.2, C114.2, C115.2, C116.2, C117.2, C118.2, C120.2, C121.2, C122.2, C124.2, C125.2, C126.2, C127.2, C128.2, C129.2, C130.1, C135.1, C137.2, C138.2, C139.2, C140.2, C141.2, C143.2, C144.2, C145.2, C146.2, C147.2, C148.2, C170.1, C171.1, C172.2, C173.2, C174.2, C175.2, D1.2 (A), DS4.1 (K), P16.A1 (GND), P16.A12 (GND), P16.B1 (GND), P16.B12 (GND), P16.GND1 (GND), P16.GND2 (GND), R12.1, R18.1, R51.1, R54.1, R61.1, R63.1, R86.1, R92.1, R100.1, R102.1, R111.1, R139.1, R149.1, R151.1, R160.1, U11.6 (GND), U11.PAD (EP), U28.6 (GND), U28.PAD (EP), U29.4 (GND), U29.PAD (EP), U30.2 (GND), U30.5 (GND), U31.9 (EP), U32.2 (GND), U35.4 (GND), U35.PAD (EP), U36.7 (GND), U36.21 (PAD), VR1.3 (GND), VR1.4 (GND), VR1.7 (NC), VR1.8 (GND), VR1.14 (GND), VR1.17 (NC), VR1.18 (NC), VR1.19 (NC), VR1.20 (NC), VR1.PAD; also elsewhere on the board
FB: R101.1, R102.2, U36.16 (FB)
IMON: R100.2, U36.17 (IMON); also elsewhere on the board
unnamed: C115.1, R148.1
unnamed: D2.2 (A), L1.2, U30.1 (SW)
unnamed: C123.1, C126.1, C146.1, D2.1 (K), R24.2, R58.2, TP3.1, U32.1 (VIN)
unnamed: DS4.2 (A), R88.1
unnamed: L4.1, VR1.5 (SW), VR1.6 (SW)
unnamed: P16.SH1 (GND), P16.SH2 (GND), P16.SH3 (GND), R86.2
unnamed: P16.SH4 (GND), P16.SH5 (GND), P16.SH6 (GND), R111.2
unnamed: R137.2, U36.1 (SENSE), U36.10 (SENSE), U36.11 (SENSE), U36.20 (SENSE)
unnamed: R9.2, U11.5 (EN)
unnamed: C140.1, U11.4 (SS)
unnamed: R11.1, R12.2, U11.3 (Sense)
unnamed: C144.1, U28.4 (SS)
unnamed: R139.2, R143.1, U28.3 (Sense)
unnamed: C171.2, U29.3 (Byp)
unnamed: R19.2, U29.7 (EN)
unnamed: C172.1, R50.2, U29.6 (REF)
unnamed: R50.1, R51.2, U29.5 (REF_SNS)
unnamed: C170.2, U29.1 (Vreg)
unnamed: C123.2, R58.1, R63.2, U30.3 (FB)
unnamed: C121.1, R57.2, U30.4 (SHDN_N)
unnamed: C125.1, U31.3 (Byp)
unnamed: R156.2, U31.4 (EN)
unnamed: C128.1, U31.5 (REF_SNS), U31.6 (REF)
unnamed: C119.2, C120.1, C122.1, C124.1, L4.2, R152.2, R153.2, R156.1, U31.8 (VIN)
unnamed: C127.1, U31.7 (VREG)
unnamed: R24.1, U32.3 (EN)
unnamed: R53.1, R54.2, U32.4 (SNS/ADJ)
unnamed: C135.2, U35.3 (Byp)
unnamed: R10.2, U35.7 (EN)
unnamed: C141.1, R17.1, U35.6 (REF)
unnamed: R17.2, R18.2, U35.5 (REF_SNS)
unnamed: C130.2, U35.1 (Vreg)
unnamed: R99.1, U36.15 (*FLT)
unnamed: C138.1, U36.6 (INTVCC)
unnamed: R92.2, U36.18 (ISET)
unnamed: R98.1, U36.14 (PG)
unnamed: C137.1, U36.5 (TIMER)
unnamed: R148.2, VR1.11 (EN/UV)
unnamed: C119.1, R151.2, R153.1, VR1.13 (FB)
unnamed: R152.1, VR1.12 (PG)
unnamed: R149.2, VR1.1 (RT)
unnamed: R160.2, VR1.16 (Sync)
unnamed: C116.1, VR1.15 (TR/SS)
unnamed: C48.1, VR1.2 (Vcc)
OV: R60.1, R61.2, U36.4 (OV)
UV: R59.1, R60.2, R99.2, U36.3 (UV)
VCTRL_1: R57.1, U28.5 (EN); also elsewhere on the board
VDD_1V8: C143.1, U35.2 (Vout); also elsewhere on the board
VDD_3V0: C174.1, U29.2 (Vout); also elsewhere on the board
VDD_3V3: C129.1, U31.1 (VOUT), U31.2 (Vout_sns); also elsewhere on the board
VDD_4V5: C145.1, R11.2, U11.1 (Vout), U11.2 (Vout); also elsewhere on the board
VDD_4V75: C147.1, R143.2, U28.1 (Vout), U28.2 (Vout); also elsewhere on the board
VDD_AMP: C173.1, C175.1, R53.2, U32.5 (VOUT); also elsewhere on the board
VINPUT: D1.1 (K), E2.1, P16.A4 (VBUS), P16.A9 (VBUS), P16.B4 (VBUS), P16.B9 (VBUS), R59.2, R88.2, R137.1, U36.2 (VDD), U36.19 (VDD); also elsewhere on the board
VSOURCE: C66.1, C68.1, C114.1, C117.1, C118.1, C139.1, C148.1, L1.1, R9.1, R10.1, R19.1, R98.2, R101.2, U11.7 (VIN), U11.8 (VIN), U28.7 (VIN), U28.8 (VIN), U29.8 (VIN), U30.6 (VIN), U35.8 (VIN), U36.8 (OUT), U36.9 (OUT), U36.12 (OUT), VR1.9 (Vin), VR1.10 (Vin)

Notes on the sheet:
HOTSWAP CONTROLLER
3.3V SUPPLY
14V SUPPLY
1.8V, 3V, 4.75V SUPPLY
POWER CONNECTOR

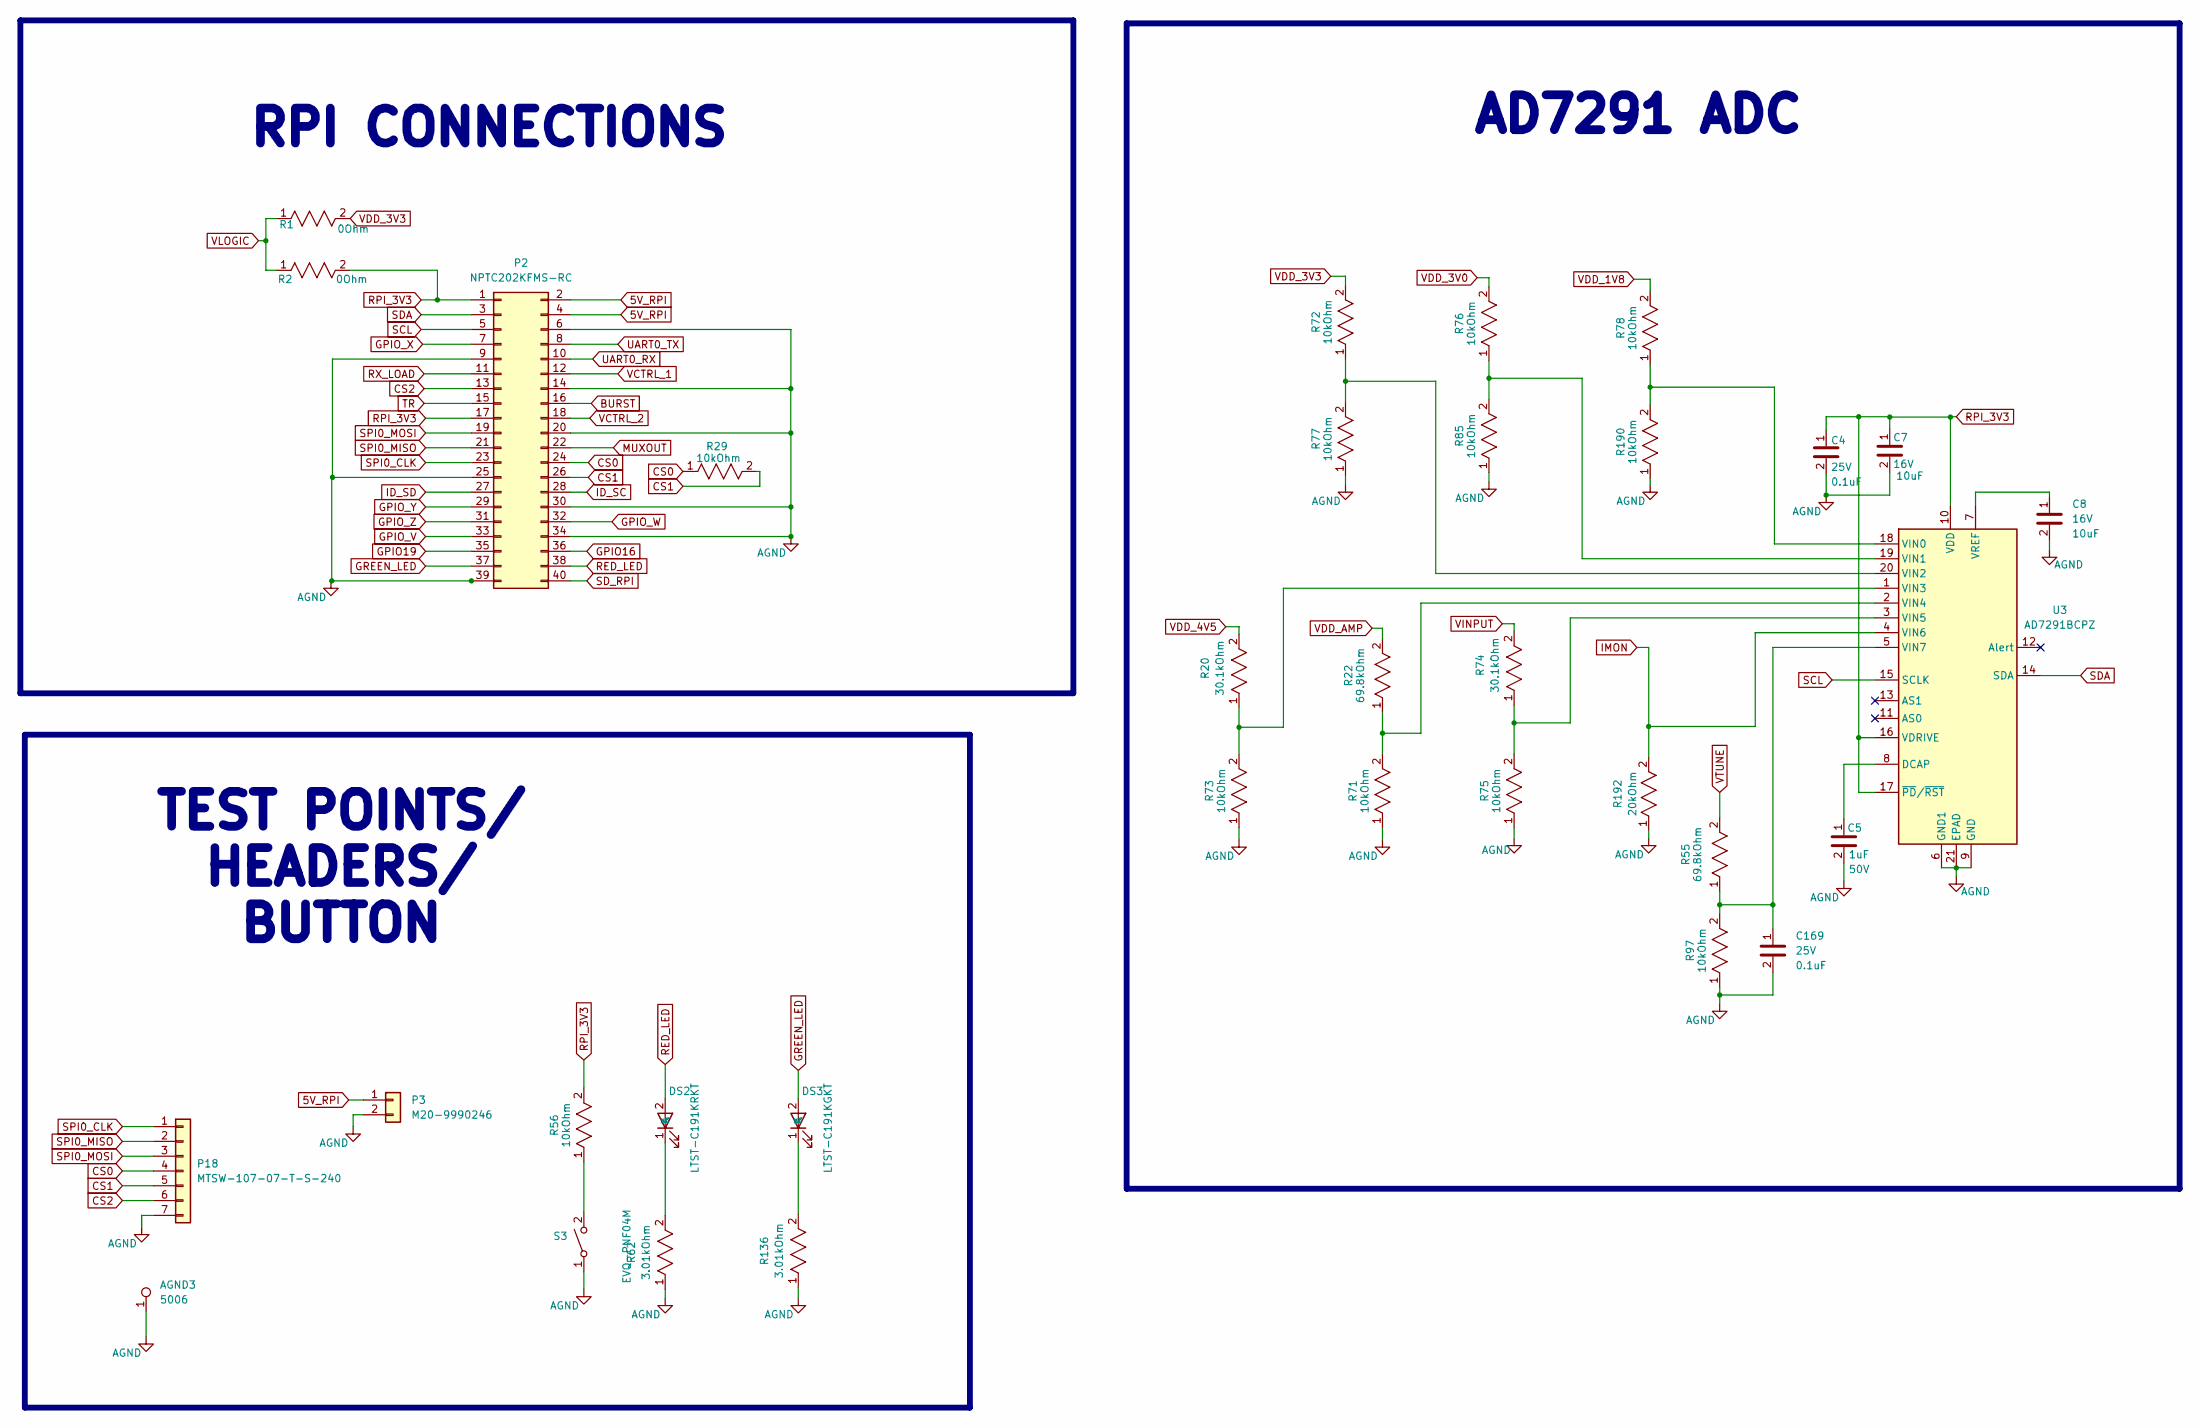
[picture p6: schematic 11.kicad_sch]

Parts:
AGND3: 5006; KEYSTONE_5009
C4, C169: CL10B104KA8NNNC; C_0603_1608Metric
C5: CL10A105KB8NNNC; C_0603_1608Metric
C7, C8: GRM188R61C106KAALD; C_0603_1608Metric
DS2: LTST-C191KRKT; LED_0603_1608Metric
DS3: LTST-C191KGKT; LED_0603_1608Metric
P2: NPTC202KFMS-RC; PinSocket_2x20_P2.54mm_Vertical_SMD
P3: M20-9990246; PinHeader_1x02_P2.54mm_Vertical
P18: MTSW-107-07-T-S-240; PinHeader_1x07_P2.54mm_Vertical
R1, R2: ERJ-3GEY0R00V; R_0603_1608Metric
R20, R74: ERJ-3EKF3012V; R_0603_1608Metric
R22, R55: ERJ-3EKF6982V; R_0603_1608Metric
R29, R56, R71, R72, R73, R75, R76, R77, R78, R85, R97, R190: ERJ-3EKF1002V; R_0603_1608Metric
R62, R136: ERJ-3EKF3011V; R_0603_1608Metric
R192: ERJ-3EKF2002V; R_0603_1608Metric
S3: EVQ-PNF04M
U3: AD7291BCPZ; LFCSP-20-1EP_4x4mm_P0.5mm_EP2.6x2.6mm

Connections:
5V_RPI: P2.2, P2.4, P3.1; also elsewhere on the board
AGND: AGND3.1, C4.2, C5.2, C7.2, C8.2, C169.2, P2.6, P2.9, P2.14, P2.20, P2.25, P2.30, P2.34, P2.39, P3.2, P18.7, R62.1, R71.1, R73.1, R75.1, R77.1, R85.1, R97.1, R136.1, R190.1, R192.1, S3.1, U3.6 (GND1), U3.9 (GND), U3.21 (EPAD); also elsewhere on the board
BURST: P2.16; also elsewhere on the board
CS0: P2.24, P18.4, R29.1; also elsewhere on the board
CS1: P2.26, P18.5, R29.2; also elsewhere on the board
CS2: P2.13, P18.6; also elsewhere on the board
GPIO16: P2.36
GPIO19: P2.35
GPIO_V: P2.33; also elsewhere on the board
GPIO_W: P2.32; also elsewhere on the board
GPIO_X: P2.7; also elsewhere on the board
GPIO_Y: P2.29; also elsewhere on the board
GPIO_Z: P2.31; also elsewhere on the board
GREEN_LED: DS3.2 (A), P2.37
ID_SC: P2.28; also elsewhere on the board
ID_SD: P2.27; also elsewhere on the board
IMON: R192.2, U3.4 (VIN6); also elsewhere on the board
MUXOUT: P2.22; also elsewhere on the board
unnamed: DS2.1 (K), R62.2
unnamed: DS3.1 (K), R136.2
unnamed: R56.1, S3.2
unnamed: C5.1, U3.8 (DCAP)
unnamed: R78.1, R190.2, U3.18 (VIN0)
unnamed: R76.1, R85.2, U3.19 (VIN1)
unnamed: R72.1, R77.2, U3.20 (VIN2)
unnamed: R20.1, R73.2, U3.1 (VIN3)
unnamed: R22.1, R71.2, U3.2 (VIN4)
unnamed: R74.1, R75.2, U3.3 (VIN5)
unnamed: C169.1, R55.1, R97.2, U3.5 (VIN7)
unnamed: C8.1, U3.7 (VREF)
RED_LED: DS2.2 (A), P2.38
RPI_3V3: C4.1, C7.1, P2.1, P2.17, R2.2, R56.2, U3.10 (VDD), U3.16 (VDRIVE), U3.17 (~PD/~RST); also elsewhere on the board
RX_LOAD: P2.11; also elsewhere on the board
SCL: P2.5, U3.15 (SCLK); also elsewhere on the board
SDA: P2.3, U3.14 (SDA); also elsewhere on the board
SD_RPI: P2.40
SPI0_CLK: P2.23, P18.1; also elsewhere on the board
SPI0_MISO: P2.21, P18.2; also elsewhere on the board
SPI0_MOSI: P2.19, P18.3; also elsewhere on the board
TR: P2.15; also elsewhere on the board
UART0_RX: P2.10
UART0_TX: P2.8
VCTRL_1: P2.12; also elsewhere on the board
VCTRL_2: P2.18; also elsewhere on the board
VDD_1V8: R78.2; also elsewhere on the board
VDD_3V0: R76.2; also elsewhere on the board
VDD_3V3: R1.2, R72.2; also elsewhere on the board
VDD_4V5: R20.2; also elsewhere on the board
VDD_AMP: R22.2; also elsewhere on the board
VINPUT: R74.2; also elsewhere on the board
VLOGIC: R1.1, R2.1; also elsewhere on the board
VTUNE: R55.2; also elsewhere on the board

Notes on the sheet:
TEST POINTS/ HEADERS/ BUTTON
AD7291 ADC
RPI CONNECTIONS

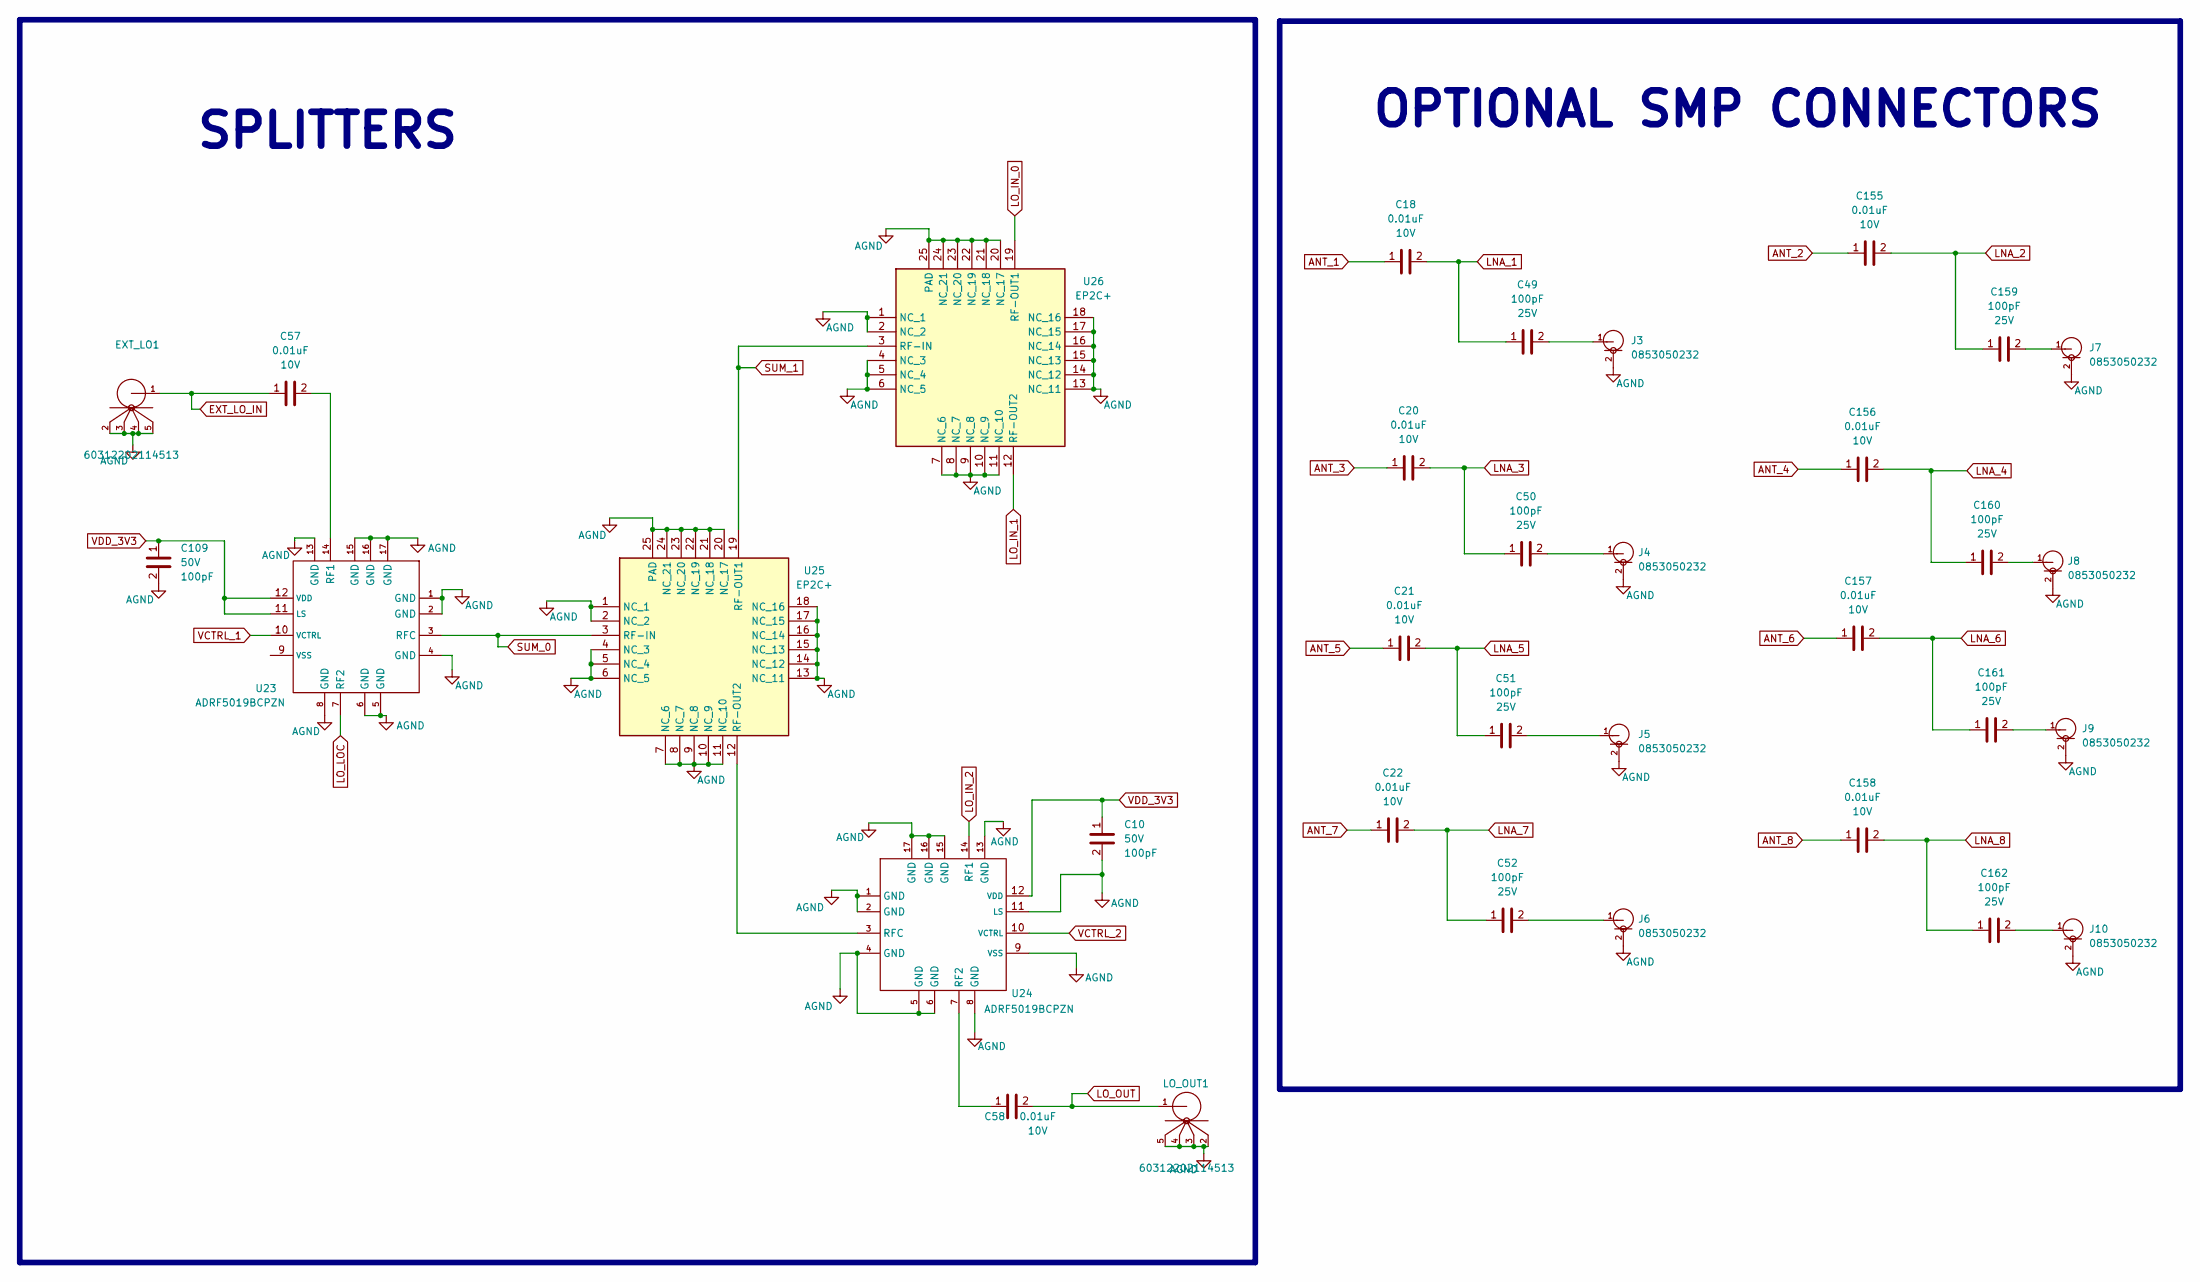
[picture p7: schematic 9.kicad_sch]

Parts:
C10, C109: CC0603KRX7R9BB101; C_0603_1608Metric
C18, C20, C21, C22, C57, C58, C155, C156, C157, C158: GRM033R71A103KA01D; C_0201_0603Metric
C49, C50, C51, C52, C159, C160, C161, C162: GRM033R71E101KA01D; C_0201_0603Metric
EXT_LO1: 60312202114513
J3, J4, J5, J6, J7, J8, J9, J10: 0853050232; MOLEX_85305-0232
LO_OUT1: 60312202114513
U23, U24: ADRF5019BCPZN; LFCSP-16-1EP_3x3mm_P0.5mm_EP1.7x1.7mm
U25, U26: EP2C+; QFN-24-1EP_4x4mm_P0.5mm_EP2.6x2.6mm

Connections:
AGND: C10.2, C109.2, EXT_LO1.2, EXT_LO1.3, EXT_LO1.4, EXT_LO1.5, J3.2, J4.2, J5.2, J6.2, J7.2, J8.2, J9.2, J10.2, LO_OUT1.2, LO_OUT1.3, LO_OUT1.4, LO_OUT1.5, U23.1 (GND), U23.2 (GND), U23.4 (GND), U23.5 (GND), U23.6 (GND), U23.8 (GND), U23.13 (GND), U23.15 (GND), U23.16 (GND), U23.17 (GND), U24.1 (GND), U24.2 (GND), U24.4 (GND), U24.5 (GND), U24.6 (GND), U24.8 (GND), U24.9 (VSS), U24.11 (LS), U24.13 (GND), U24.15 (GND), U24.16 (GND), U24.17 (GND), U25.1 (NC_1), U25.2 (NC_2), U25.4 (NC_3), U25.5 (NC_4), U25.6 (NC_5), U25.7 (NC_6), U25.8 (NC_7), U25.9 (NC_8), U25.10 (NC_9), U25.11 (NC_10), U25.13 (NC_11), U25.14 (NC_12), U25.15 (NC_13), U25.16 (NC_14), U25.17 (NC_15), U25.18 (NC_16), U25.20 (NC_17), U25.21 (NC_18), U25.22 (NC_19), U25.23 (NC_20), U25.24 (NC_21), U25.25 (PAD), U26.1 (NC_1), U26.2 (NC_2), U26.4 (NC_3), U26.5 (NC_4), U26.6 (NC_5), U26.7 (NC_6), U26.8 (NC_7), U26.9 (NC_8), U26.10 (NC_9), U26.11 (NC_10), U26.13 (NC_11), U26.14 (NC_12), U26.15 (NC_13), U26.16 (NC_14), U26.17 (NC_15), U26.18 (NC_16), U26.20 (NC_17), U26.21 (NC_18), U26.22 (NC_19), U26.23 (NC_20), U26.24 (NC_21), U26.25 (PAD); also elsewhere on the board
ANT_1: C18.1; also elsewhere on the board
ANT_2: C155.1; also elsewhere on the board
ANT_3: C20.1; also elsewhere on the board
ANT_4: C156.1; also elsewhere on the board
ANT_5: C21.1; also elsewhere on the board
ANT_6: C157.1; also elsewhere on the board
ANT_7: C22.1; also elsewhere on the board
ANT_8: C158.1; also elsewhere on the board
EXT_LO_IN: C57.1, EXT_LO1.1
LNA_1: C18.2, C49.1; also elsewhere on the board
LNA_2: C155.2, C159.1; also elsewhere on the board
LNA_3: C20.2, C50.1; also elsewhere on the board
LNA_4: C156.2, C160.1; also elsewhere on the board
LNA_5: C21.2, C51.1; also elsewhere on the board
LNA_6: C157.2, C161.1; also elsewhere on the board
LNA_7: C22.2, C52.1; also elsewhere on the board
LNA_8: C158.2, C162.1; also elsewhere on the board
LO_IN_0: U26.19 (RF-OUT1); also elsewhere on the board
LO_IN_1: U26.12 (RF-OUT2); also elsewhere on the board
LO_IN_2: U24.14 (RF1); also elsewhere on the board
LO_LOC: U23.7 (RF2); also elsewhere on the board
LO_OUT: C58.2, LO_OUT1.1
unnamed: C49.2, J3.1
unnamed: C50.2, J4.1
unnamed: C51.2, J5.1
unnamed: C52.2, J6.1
unnamed: C159.2, J7.1
unnamed: C160.2, J8.1
unnamed: C161.2, J9.1
unnamed: C162.2, J10.1
unnamed: C57.2, U23.14 (RF1)
unnamed: C58.1, U24.7 (RF2)
unnamed: U24.3 (RFC), U25.12 (RF-OUT2)
SUM_0: U23.3 (RFC), U25.3 (RF-IN)
SUM_1: U25.19 (RF-OUT1), U26.3 (RF-IN)
VCTRL_1: U23.10 (VCTRL); also elsewhere on the board
VCTRL_2: U24.10 (VCTRL); also elsewhere on the board
VDD_3V3: C10.1, C109.1, U23.11 (LS), U23.12 (VDD), U24.12 (VDD); also elsewhere on the board

Notes on the sheet:
OPTIONAL SMP CONNECTORS
SPLITTERS

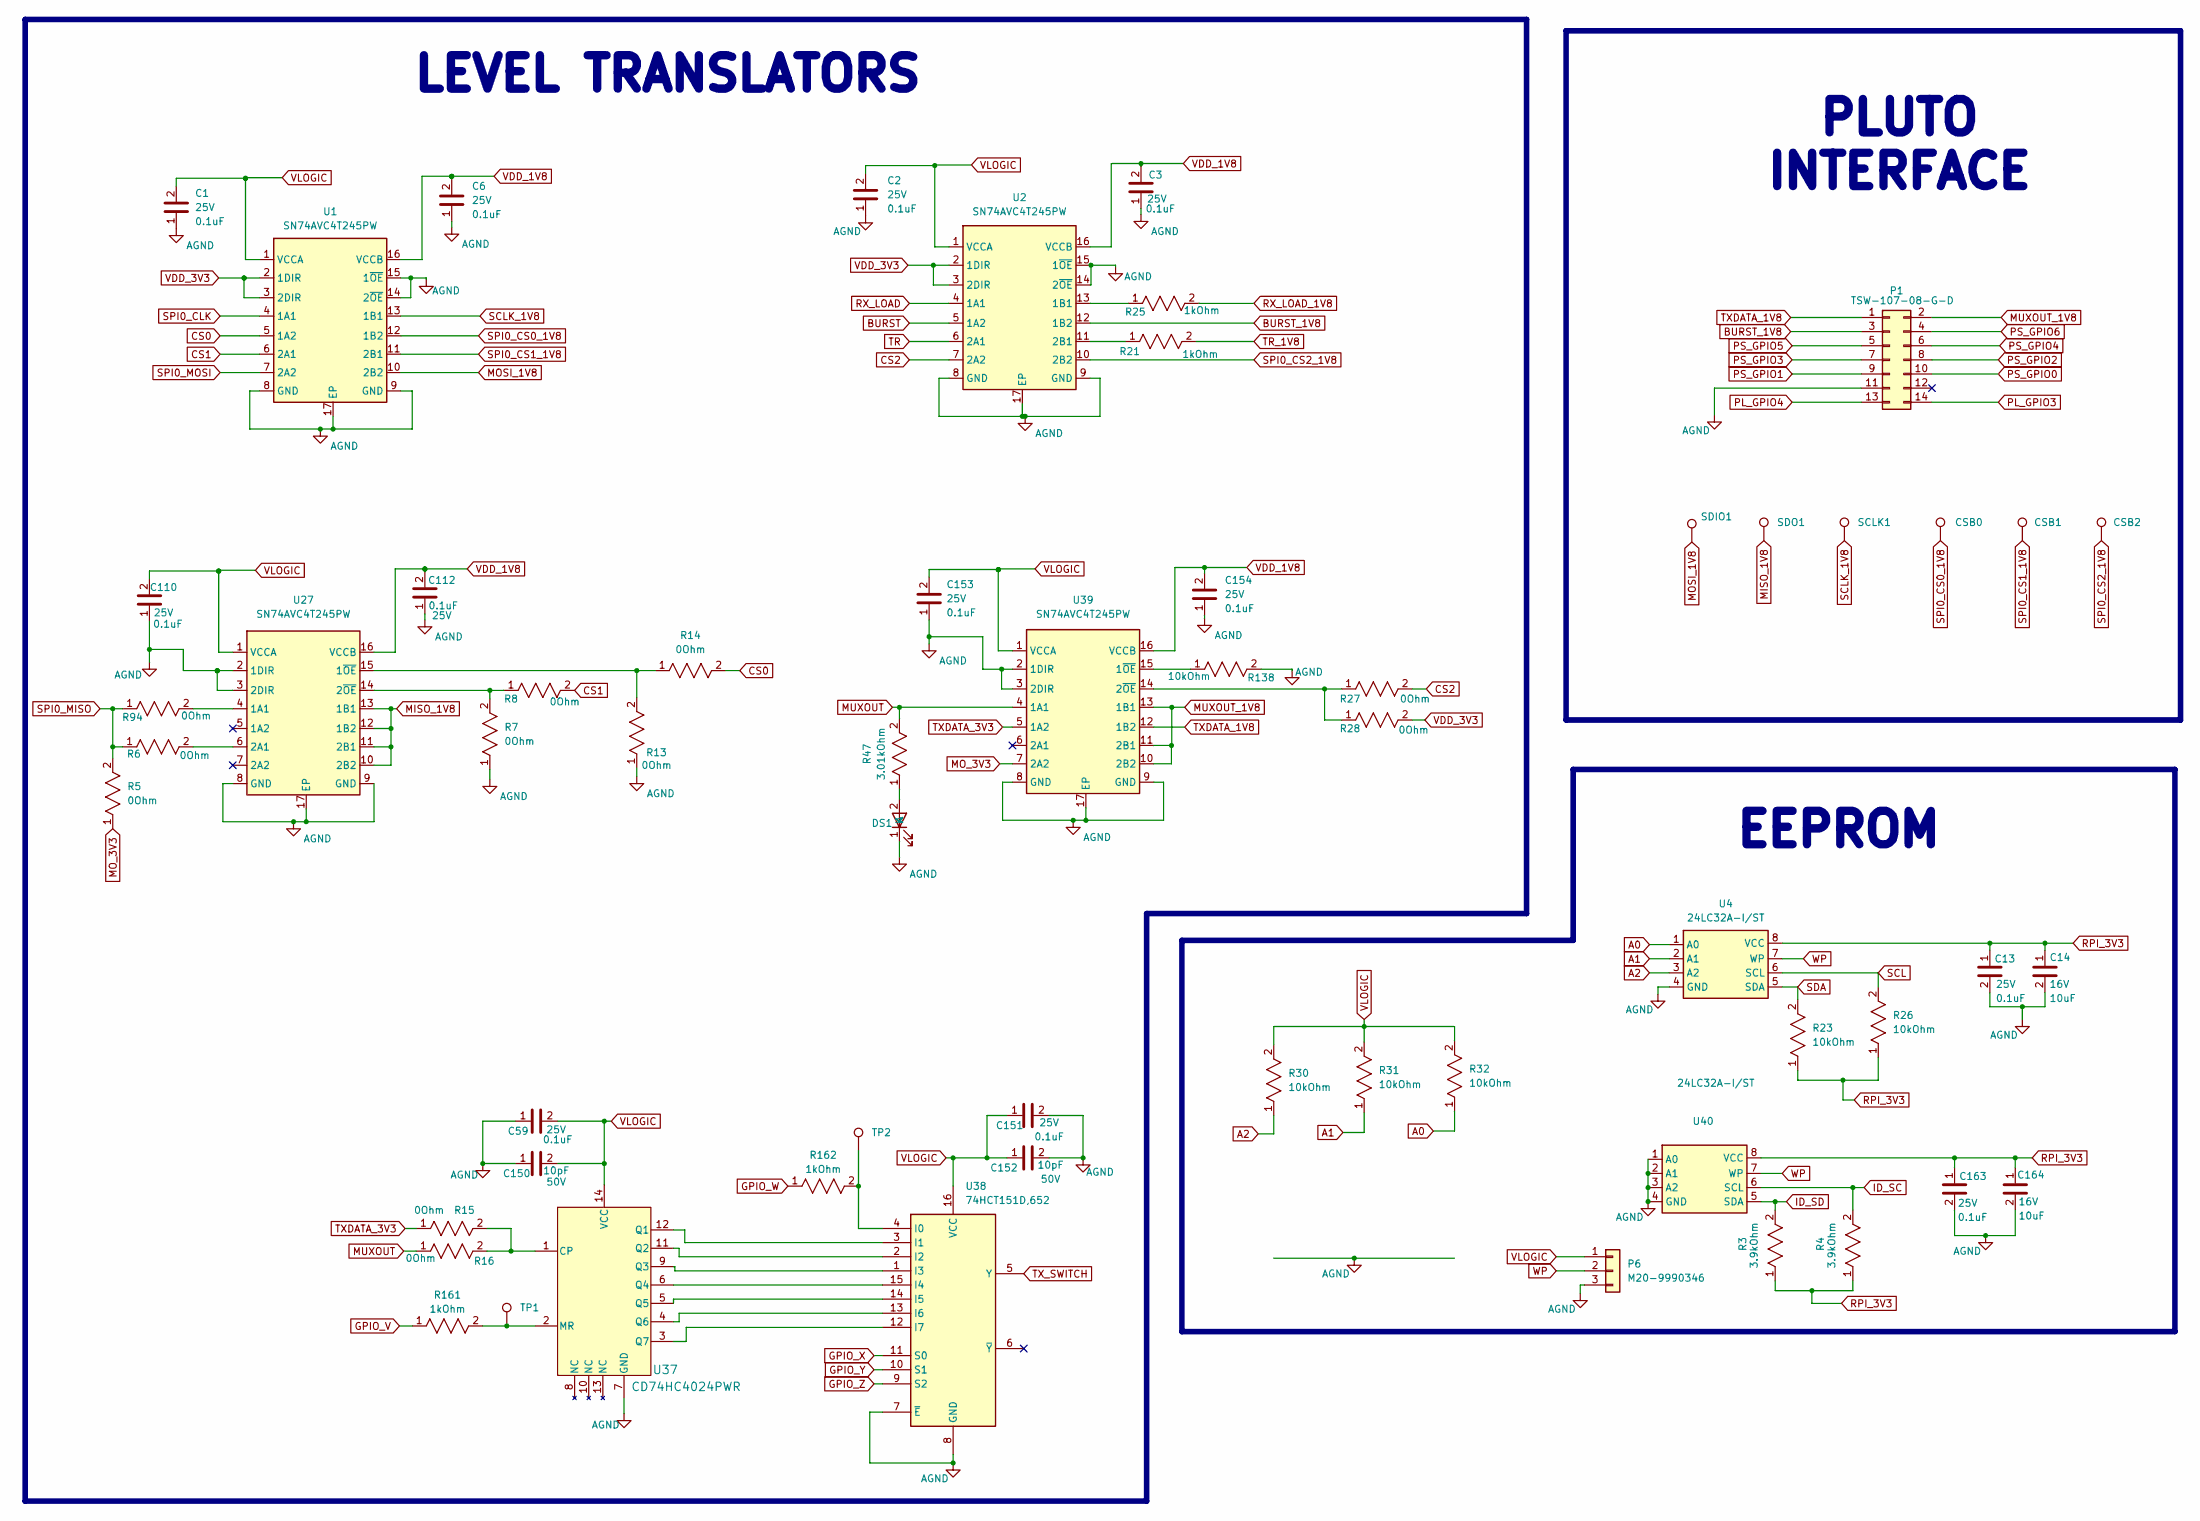
[picture p8: schematic 12.kicad_sch]

Parts:
C1, C2, C3, C6, C13, C59, C110, C112, C151, C153, C154, C163: CL10B104KA8NNNC; C_0603_1608Metric
C14, C164: GRM188R61C106KAALD; C_0603_1608Metric
C150, C152: CL10C100JB8NNNC; C_0603_1608Metric
CSB0, CSB1, CSB2: TestPoint; Testpoint
DS1: 150060YS75000; LED_0603_1608Metric
P1: TSW-107-08-G-D; PinHeader_2x07_P2.54mm_Vertical
P6: M20-9990346; PinHeader_1x03_P2.54mm_Vertical
R3, R4: ERJ-2RKF3901X; R_0402_1005Metric
R5, R6, R7, R8, R13, R14, R15, R16, R27, R28, R94: ERJ-3GEY0R00V; R_0603_1608Metric
R21, R25, R161, R162: ERJ-3EKF1001V; R_0603_1608Metric
R23, R26, R30, R31, R32, R138: ERJ-3EKF1002V; R_0603_1608Metric
R47: ERJ-3EKF3011V; R_0603_1608Metric
SCLK1: TestPoint; Testpoint
SDIO1: TestPoint; Testpoint
SDO1: TestPoint; Testpoint
TP1, TP2: TestPoint; Testpoint
U1, U2, U27, U39: SN74AVC4T245PW; TSSOP-16-1EP_4.4x5mm_P0.65mm_EP3x3mm
U4, U40: 24LC32A-I/ST; TSSOP-8_4.4x3mm_P0.65mm
U37: CD74HC4024PWR; TSSOP-14_4.4x5mm_P0.65mm
U38: 74HCT151D,652; SOIC-16_3.9x9.9mm_P1.27mm

Connections:
A0: R32.1, U4.1 (A0)
A1: R31.1, U4.2 (A1)
A2: R30.1, U4.3 (A2)
AGND: C1.1, C2.1, C3.1, C6.1, C13.2, C14.2, C59.1, C110.1, C112.1, C150.1, C151.2, C152.2, C153.1, C154.1, C163.2, C164.2, DS1.1 (K), P1.11, P6.3, R7.1, R13.1, R138.2, U1.8 (GND), U1.9 (GND), U1.14 (2~OE), U1.15 (1~OE), U1.17 (EP), U2.8 (GND), U2.9 (GND), U2.14 (2~OE), U2.15 (1~OE), U2.17 (EP), U4.4 (GND), U27.2 (1DIR), U27.3 (2DIR), U27.8 (GND), U27.9 (GND), U27.17 (EP), U37.7 (GND), U38.7 (~E), U38.8 (GND), U39.2 (1DIR), U39.3 (2DIR), U39.8 (GND), U39.9 (GND), U39.17 (EP), U40.1 (A0), U40.2 (A1), U40.3 (A2), U40.4 (GND); also elsewhere on the board
BURST: U2.5 (1A2); also elsewhere on the board
BURST_1V8: P1.3, U2.12 (1B2)
CS0: R14.2, U1.5 (1A2); also elsewhere on the board
CS1: R8.2, U1.6 (2A1); also elsewhere on the board
CS2: R27.2, U2.7 (2A2); also elsewhere on the board
GPIO_V: R161.1; also elsewhere on the board
GPIO_W: R162.1; also elsewhere on the board
GPIO_X: U38.11 (S0); also elsewhere on the board
GPIO_Y: U38.10 (S1); also elsewhere on the board
GPIO_Z: U38.9 (S2); also elsewhere on the board
ID_SC: R4.2, U40.6 (SCL); also elsewhere on the board
ID_SD: R3.2, U40.5 (SDA); also elsewhere on the board
MISO_1V8: SDO1.1, U27.10 (2B2), U27.11 (2B1), U27.12 (1B2), U27.13 (1B1); also elsewhere on the board
MOSI_1V8: SDIO1.1, U1.10 (2B2); also elsewhere on the board
MO_3V3: R5.1, U39.7 (2A2)
MUXOUT: R16.1, R47.2, U39.4 (1A1); also elsewhere on the board
MUXOUT_1V8: P1.2, U39.10 (2B2), U39.11 (2B1), U39.13 (1B1); also elsewhere on the board
unnamed: DS1.2 (A), R47.1
unnamed: R25.1, U2.13 (1B1)
unnamed: R21.1, U2.11 (2B1)
unnamed: R94.2, U27.4 (1A1)
unnamed: R13.2, R14.1, U27.15 (1~OE)
unnamed: R6.2, U27.6 (2A1)
unnamed: R7.2, R8.1, U27.14 (2~OE)
unnamed: R15.2, R16.2, U37.1 (CP)
unnamed: R161.2, TP1.1, U37.2 (MR)
unnamed: U37.12 (Q1), U38.3 (I1)
unnamed: U37.11 (Q2), U38.2 (I2)
unnamed: U37.9 (Q3), U38.1 (I3)
unnamed: U37.6 (Q4), U38.15 (I4)
unnamed: U37.5 (Q5), U38.14 (I5)
unnamed: U37.4 (Q6), U38.13 (I6)
unnamed: U37.3 (Q7), U38.12 (I7)
unnamed: R162.2, TP2.1, U38.4 (I0)
unnamed: R138.1, U39.15 (1~OE)
unnamed: R27.1, R28.1, U39.14 (2~OE)
PL_GPIO3: P1.14
PL_GPIO4: P1.13
PS_GPIO0: P1.10
PS_GPIO1: P1.9
PS_GPIO2: P1.8
PS_GPIO3: P1.7
PS_GPIO4: P1.6
PS_GPIO5: P1.5
PS_GPIO6: P1.4
RPI_3V3: C13.1, C14.1, C163.1, C164.1, R3.1, R4.1, R23.1, R26.1, U4.8 (VCC), U40.8 (VCC); also elsewhere on the board
RX_LOAD: U2.4 (1A1); also elsewhere on the board
RX_LOAD_1V8: R25.2; also elsewhere on the board
SCL: R26.2, U4.6 (SCL); also elsewhere on the board
SCLK_1V8: SCLK1.1, U1.13 (1B1); also elsewhere on the board
SDA: R23.2, U4.5 (SDA); also elsewhere on the board
SPI0_CLK: U1.4 (1A1); also elsewhere on the board
SPI0_CS0_1V8: CSB0.1, U1.12 (1B2); also elsewhere on the board
SPI0_CS1_1V8: CSB1.1, U1.11 (2B1); also elsewhere on the board
SPI0_CS2_1V8: CSB2.1, U2.10 (2B2); also elsewhere on the board
SPI0_MISO: R5.2, R6.1, R94.1; also elsewhere on the board
SPI0_MOSI: U1.7 (2A2); also elsewhere on the board
TR: U2.6 (2A1); also elsewhere on the board
TR_1V8: R21.2; also elsewhere on the board
TXDATA_1V8: P1.1, U39.12 (1B2); also elsewhere on the board
TXDATA_3V3: R15.1, U39.5 (1A2)
TX_SWITCH: U38.5 (Y); also elsewhere on the board
VDD_1V8: C3.2, C6.2, C112.2, C154.2, U1.16 (VCCB), U2.16 (VCCB), U27.16 (VCCB), U39.16 (VCCB); also elsewhere on the board
VDD_3V3: R28.2, U1.2 (1DIR), U1.3 (2DIR), U2.2 (1DIR), U2.3 (2DIR); also elsewhere on the board
VLOGIC: C1.2, C2.2, C59.2, C110.2, C150.2, C151.1, C152.1, C153.2, P6.1, R30.2, R31.2, R32.2, U1.1 (VCCA), U2.1 (VCCA), U27.1 (VCCA), U37.14 (VCC), U38.16 (VCC), U39.1 (VCCA); also elsewhere on the board
WP: P6.2, U4.7 (WP), U40.7 (WP)

Notes on the sheet:
PLUTO INTERFACE
LEVEL TRANSLATORS
EEPROM
