RabbitTigers/CN0566Allegro2KiCAD/PABA-DP.kicad_pcb

## KiCad design PABA-DP.kicad_pcb (continued)

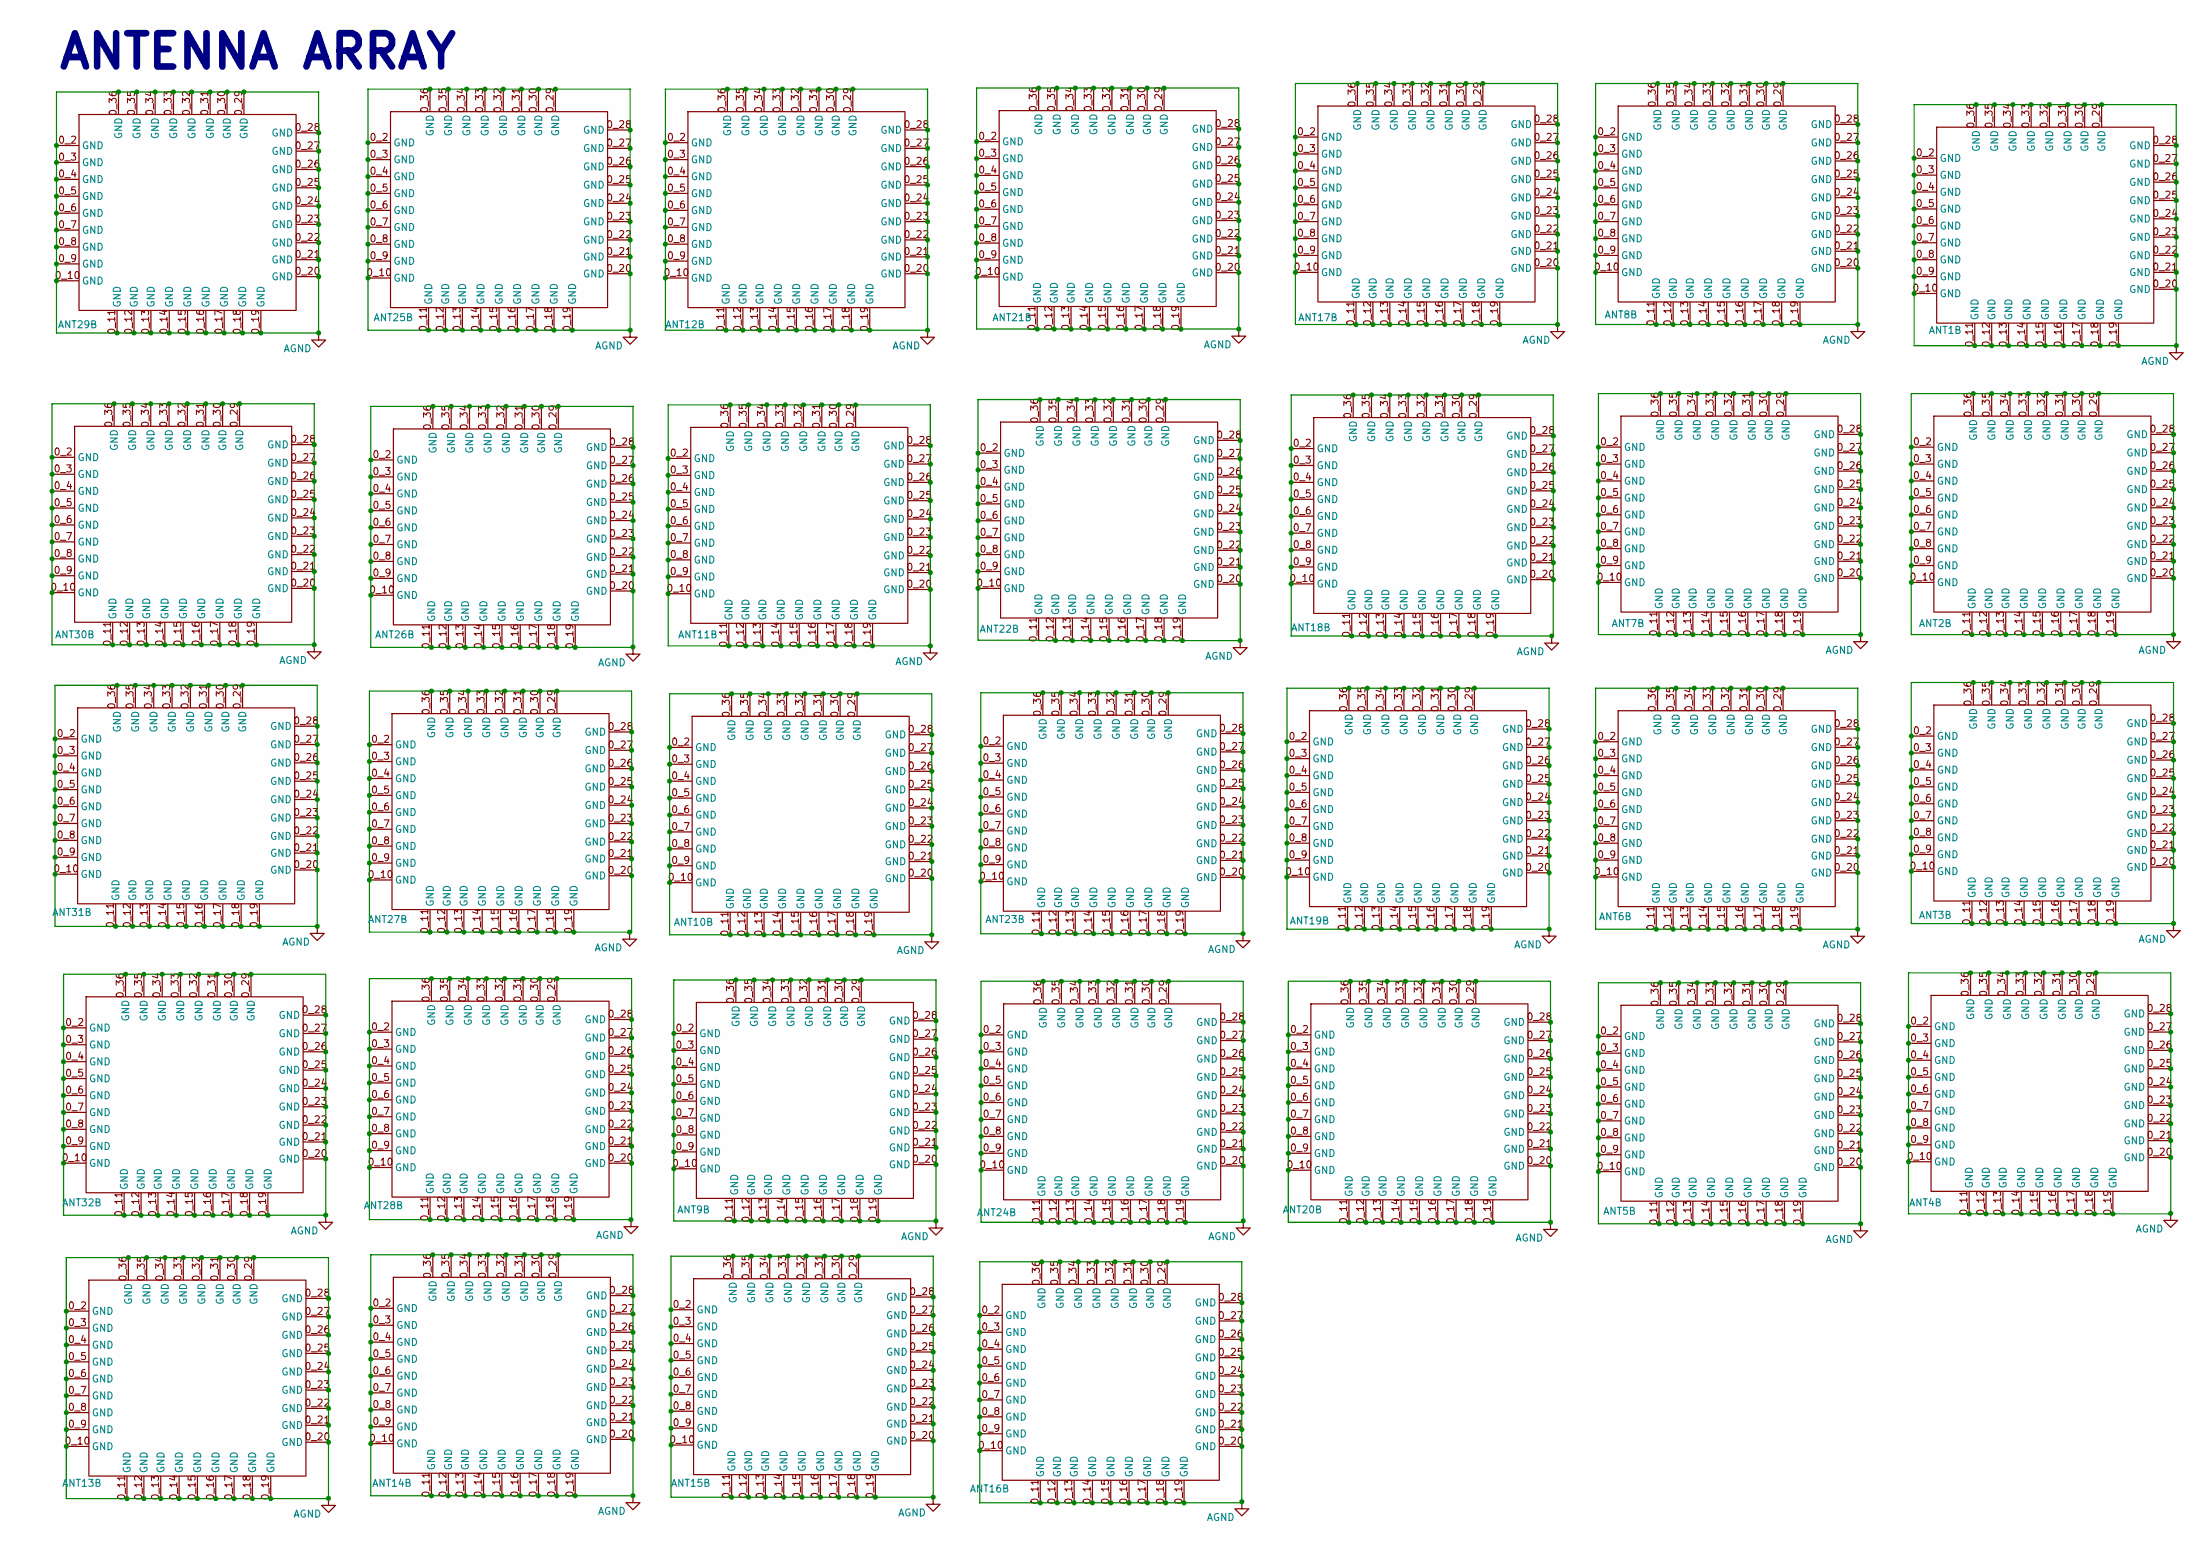
[picture p9: schematic 3.kicad_sch]

Parts:
ANT1, ANT2, ANT3, ANT4, ANT5, ANT6, ANT7, ANT8, ANT9, ANT10, ANT11, ANT12, ANT13, ANT14, ANT15, ANT16, ANT17, ANT18, ANT19, ANT20, ANT21, ANT22, ANT23, ANT24, ANT25, ANT26, ANT27, ANT28, ANT29, ANT30, ANT31, ANT32: Patch_Ant; Patch Antenna

Connections:
AGND: ANT1.0_2 (GND), ANT1.0_3 (GND), ANT1.0_4 (GND), ANT1.0_5 (GND), ANT1.0_6 (GND), ANT1.0_7 (GND), ANT1.0_8 (GND), ANT1.0_9 (GND), ANT1.0_10 (GND), ANT1.0_11 (GND), ANT1.0_12 (GND), ANT1.0_13 (GND), ANT1.0_14 (GND), ANT1.0_15 (GND), ANT1.0_16 (GND), ANT1.0_17 (GND), ANT1.0_18 (GND), ANT1.0_19 (GN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

Notes on the sheet:
ANTENNA ARRAY

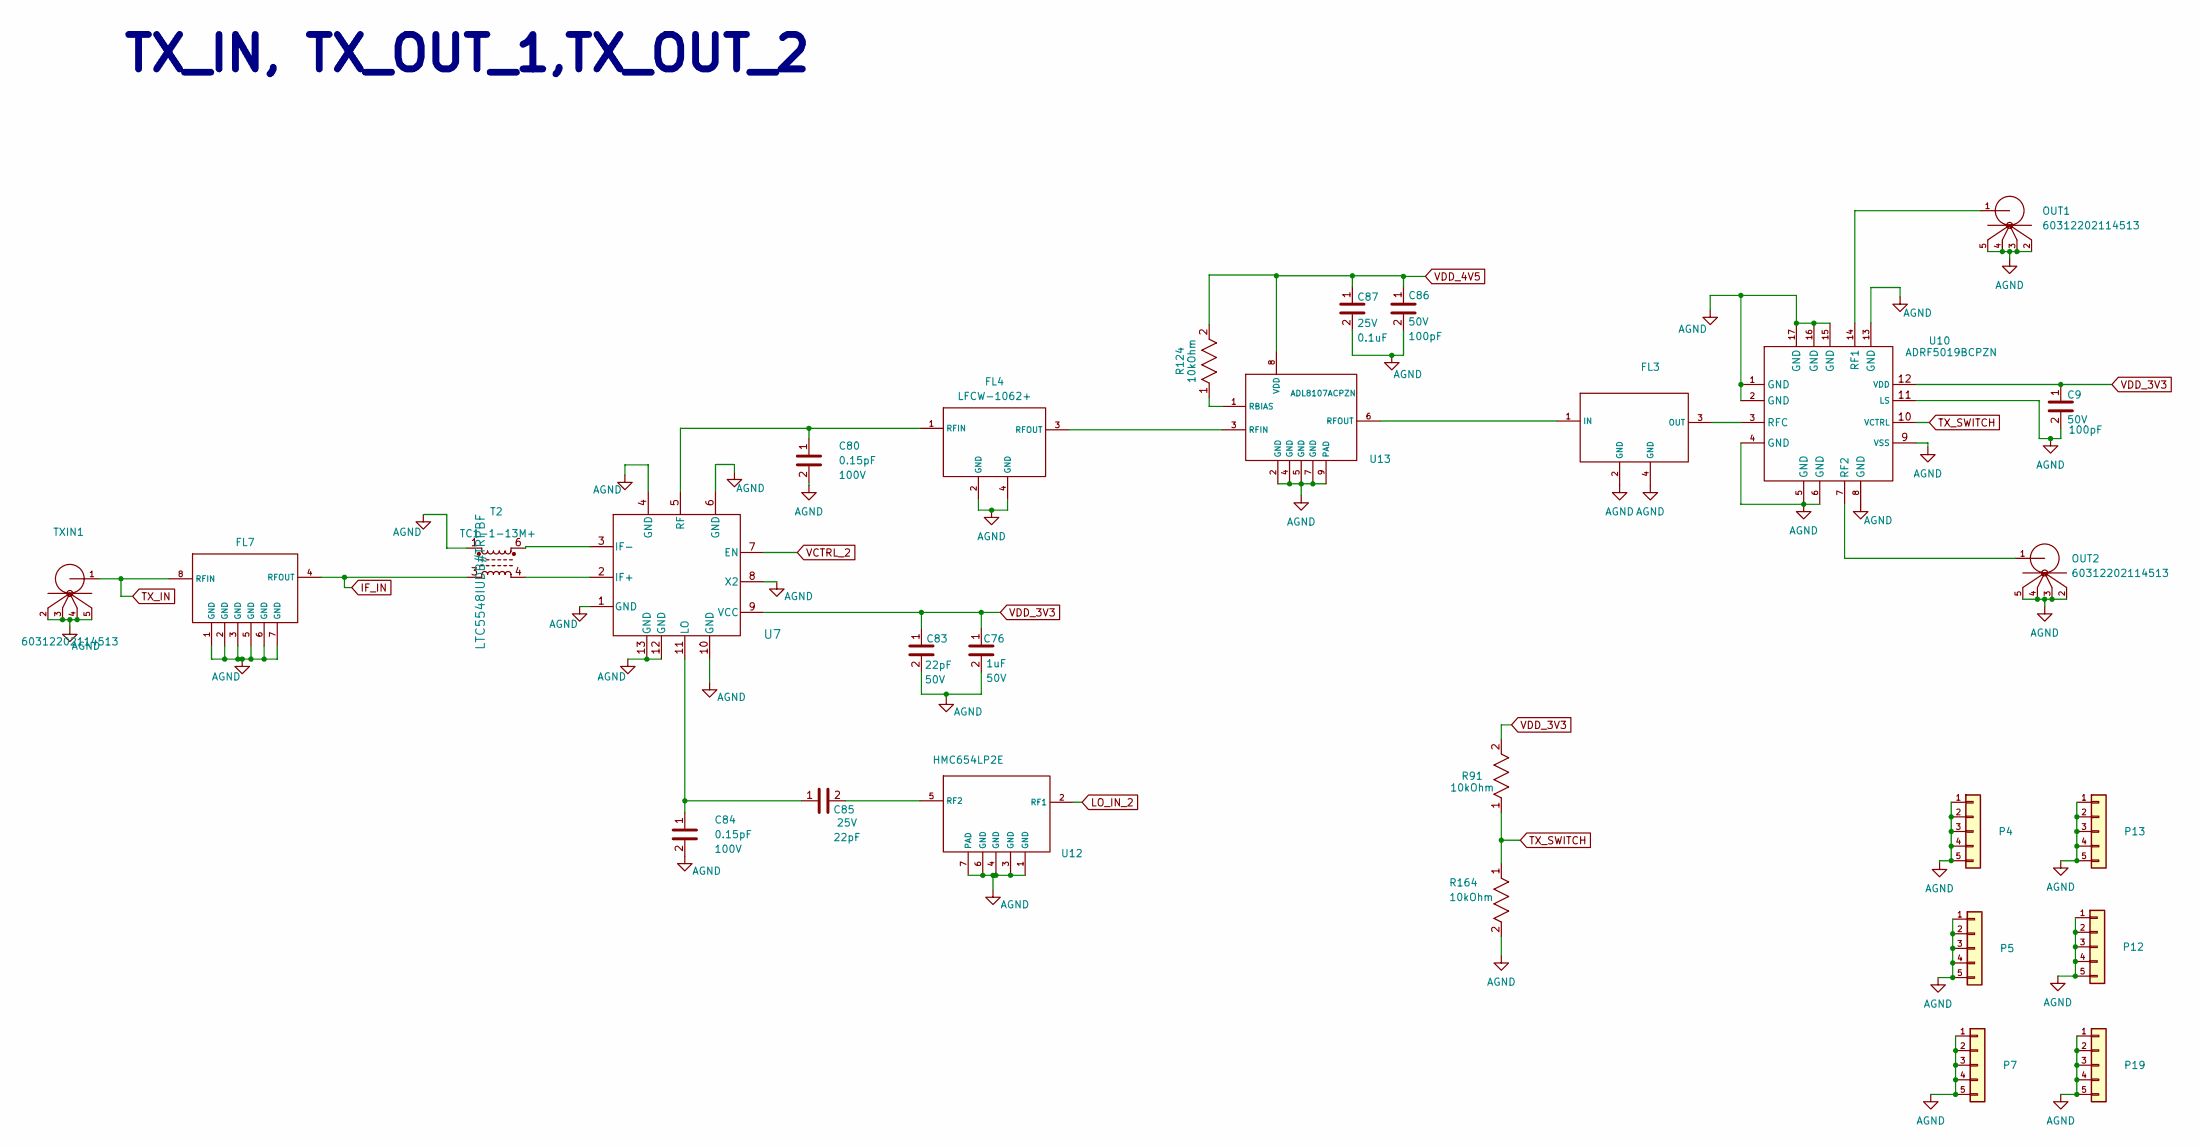
[picture p10: schematic 7.kicad_sch]

Parts:
C9, C86: CC0603KRX7R9BB101; C_0603_1608Metric
C76: CL10A105KB8NNNC; C_0603_1608Metric
C80, C84: 02011JR15ZBSTR; C_0201_0603Metric
C83: 06035C220JAT2A; C_0603_1608Metric
C85: GRM0335C1E220JA01D; C_0201_0603Metric
C87: CL10B104KA8NNNC; C_0603_1608Metric
FL3: BFCN-1052+; BFCN1052
FL4: LFCW-1062+
FL7: LFCG-2500+; LFCG2500
OUT1, OUT2: 60312202114513
P4, P5, P7, P12, P13, P19: 36900000
R91, R124, R164: ERJ-3EKF1002V; R_0603_1608Metric
T2: TC1-1-13M+
TXIN1: 60312202114513
U7: LTC5548IUDB#TRPBF
U10: ADRF5019BCPZN; LFCSP-16-1EP_3x3mm_P0.5mm_EP1.7x1.7mm
U12: HMC654LP2E; HMC652LP2E TDFN 2x2
U13: ADL8107ACPZN; ADL8107ACPZN-R7

Connections:
AGND: C9.2, C76.2, C80.2, C83.2, C84.2, C86.2, C87.2, FL3.2 (GND), FL3.4 (GND), FL4.2 (GND), FL4.4 (GND), FL7.1 (GND), FL7.2 (GND), FL7.3 (GND), FL7.5 (GND), FL7.6 (GND), FL7.7 (GND), OUT1.2, OUT1.3, OUT1.4, OUT1.5, OUT2.2, OUT2.3, OUT2.4, OUT2.5, P4.1, P4.2, P4.3, P4.4, P4.5, P5.1, P5.2, P5.3, P5.4, P5.5, P7.1, P7.2, P7.3, P7.4, P7.5, P12.1, P12.2, P12.3, P12.4, P12.5, P13.1, P13.2, P13.3, P13.4, P13.5, P19.1, P19.2, P19.3, P19.4, P19.5, R164.2, T2.1, TXIN1.2, TXIN1.3, TXIN1.4, TXIN1.5, U7.1 (GND), U7.4 (GND), U7.6 (GND), U7.8 (X2), U7.10 (GND), U7.12 (GND), U7.13 (GND), U10.1 (GND), U10.2 (GND), U10.4 (GND), U10.5 (GND), U10.6 (GND), U10.8 (GND), U10.9 (VSS), U10.11 (LS), U10.13 (GND), U10.15 (GND), U10.16 (GND), U10.17 (GND), U12.1 (GND), U12.3 (GND), U12.4 (GND), U12.6 (GND), U12.7 (PAD), U13.2 (GND), U13.4 (GND), U13.5 (GND), U13.7 (GND), U13.9 (PAD); also elsewhere on the board
IF_IN: FL7.4 (RFOUT), T2.3
LO_IN_2: U12.2 (RF1); also elsewhere on the board
unnamed: FL3.1 (IN), U13.6 (RFOUT)
unnamed: FL3.3 (OUT), U10.3 (RFC)
unnamed: C80.1, FL4.1 (RFIN), U7.5 (RF)
unnamed: FL4.3 (RFOUT), U13.3 (RFIN)
unnamed: T2.4, U7.2 (IF+)
unnamed: T2.6, U7.3 (IF-)
unnamed: C84.1, C85.1, U7.11 (LO)
unnamed: OUT1.1, U10.14 (RF1)
unnamed: OUT2.1, U10.7 (RF2)
unnamed: C85.2, U12.5 (RF2)
unnamed: R124.1, U13.1 (RBIAS)
TX_IN: FL7.8 (RFIN), TXIN1.1
TX_SWITCH: R91.1, R164.1, U10.10 (VCTRL); also elsewhere on the board
VCTRL_2: U7.7 (EN); also elsewhere on the board
VDD_3V3: C9.1, C76.1, C83.1, R91.2, U7.9 (VCC), U10.12 (VDD); also elsewhere on the board
VDD_4V5: C86.1, C87.1, R124.2, U13.8 (VDD); also elsewhere on the board

Notes on the sheet:
TX_IN, TX_OUT_1,TX_OUT_2

Board: 2 copper layers, 502 parts (27 on the bottom side), 269 nets, no tracks yet.
